jms1005/coss-led-pedd-analyzer/계획서_수정사항.md

# 계획서 수정 항목 — 적용 완료 (2026-09-03)

> ✅ **①②③④는 `LED_PEDD_계획서_최종본.docx`에 이미 반영했습니다.**
> 원본은 `backup/LED_PEDD_계획서_최종본_원본_20260903.docx`에 보관돼 있습니다.
>
> ⚠️ **⑤ 그림 삽입만 Word에서 직접 하셔야 합니다.** 해당 위치에
> `★ ... 교체할 것 ★` 표시를 넣어두었으니 그 문단을 지우고 그림을 넣으세요.
>
> ⑥은 실험 후에 채우는 항목입니다.

아래는 무엇을 왜 바꿨는지에 대한 기록입니다.

`LED_PEDD_계획서_최종본.docx` 검토 결과, 실제 진행에 앞서 고쳐야 할 곳입니다.
**①②③은 안 고치면 실험이 진행되지 않는 항목**이고, ④⑤⑥은 문서 완성도 항목입니다.

원본 파일은 제출용이라 임의로 수정하지 않았습니다.
아래대로 직접 고치시거나, 말씀해주시면 제가 반영하겠습니다.

---

## ① 5.1절 BOM — 누락 부품 (Uno 보드 사용 결정 반영)

> **2026-09-03 갱신.** Arduino Uno 호환보드를 쓰기로 결정했으므로 크리스털·
> 커패시터·USB-TTL은 **구매할 필요가 없습니다**(보드에 실장되어 있음).
> 다만 아래 크리스털·22pF는 **제출용 원가표에는 남겨야** 합니다. 5.1절은
> "ATmega328P IC 단품 5,000원" 기준의 최종 시스템 원가표인데, 단품 구성에는
> 크리스털이 실제로 필요하기 때문입니다. USB-TTL은 최종 시스템의 출력이
> OLED이므로(1.4절) 원가표에서도 제외합니다.
>
> 실제 구매 목록은 `구매목록.md`를 보세요.

### 16MHz 크리스털 + 22pF 커패시터

계획서 3.6절은 **"16 MHz 동작 기준"** 으로 프리스케일러 /8에서 500ns
분해능을 도출하고, 이것이 프리스케일러 선정의 유일한 근거로 쓰였습니다.

그런데 ATmega328P **DIP 단품은 공장 출하 시 내부 8MHz RC 발진기**로
동작합니다. 외부 크리스털과 로드 커패시터가 없으면 16MHz가 나오지
않고, 분해능은 계획서가 말한 500ns가 아니라 1μs가 됩니다.
게다가 내부 RC는 온도에 따라 수 % 흔들려서, 온도 안정성을 확보하려고
밴드갭 기준을 고른 3.2절의 논리와도 어긋납니다.

BOM 표에 다음 행을 추가하세요.

| 품목 | 사양 | 수량 | 예상 단가 | 소계 | 비고 |
|---|---|---|---|---|---|
| 크리스털 | 16 MHz HC-49S | 1 | 300 | 300 | 클럭 정확도 확보 |
| 세라믹 커패시터 | 22 pF | 2 | 50 | 100 | 크리스털 로드 |

> Arduino Uno 보드에는 이미 실장되어 있습니다. 하지만 경제성 산출은
> IC 단품 기준으로 하므로, BOM에는 반드시 들어가야 합니다.

### USB-TTL 시리얼 어댑터

계획서 6.4절 5항은 "모든 원시 측정값을 UART로 PC에 로깅"한다고 했고,
3.5절 핀 표에도 UART 2핀이 잡혀 있습니다. 그런데 **ATmega328P의 UART는
TTL 레벨 신호일 뿐, PC의 USB에 직접 연결되지 않습니다.**
변환 어댑터가 없으면 데이터를 받을 방법이 없습니다.

**결론: 구매도 원가표 계상도 불필요합니다.** Uno 보드의 USB 단자가 이
역할을 하고, 최종 시스템의 출력은 OLED이므로 완성품에는 들어가지 않습니다.

### 합계 갱신

크리스털 300 + 22pF 100 = 400원 추가.
④항의 누락 부품까지 합한 최종 합계는 아래 ④의 표를 보세요.

---

## ② 5.3절 구매 전략 — 전제가 성립하지 않음 (필수)

**현재 문장**

> 정식 부품 발주 전, Phase 1 개념 증명은 보유 중인 LED와 개발 보드만으로
> 우선 수행한다. 개념 증명이 성공적으로 확인된 이후에 RGB 확장용 LED와
> 표시 장치를 구매하여 불필요한 지출과 시간 낭비를 방지한다.

**문제점**

이 전략은 LED와 개발 보드를 이미 갖고 있다는 전제 위에 서 있는데,
실제로는 아무것도 보유하고 있지 않습니다. 그대로 따르면 Phase 1을
위해 한 번 주문하고 배송을 기다린 뒤, Phase 2를 위해 다시 주문하고 또
기다리게 됩니다. **예선 마감까지 15일뿐이라 배송 대기를 두 번 감당할
여유가 없습니다.**

**수정안**

> 부품을 보유하고 있지 않으므로, 착수 시점에 Phase 1~2에 필요한 부품을
> 일괄 발주한다. 개발 기간이 제한되어 있어 단계별 분할 발주 시 배송
> 대기가 반복되고, 이는 실험 일정에 직접적인 지연 요인이 되기 때문이다.
> 다만 최종 시연용 표시 장치(OLED)와 소모품은 Phase 1~2 결과에 따라
> 구성이 바뀔 수 있으므로 예비 수량만 확보한다. 파장별 LED는 개체차
> 보정 실험(4.3절)에 필요하므로 파장당 5개 이상 확보한다. 개발 보드는
> 파손 시 일정 지연이 크므로 예비 1대를 함께 확보한다.

**추가로 삭제할 문장**

5.3절 마지막의 다음 문장을 지우세요.

> ~~다만 ISP 프로그래머는 툴체인 검증에 필요하므로 착수 시점에 함께 확보한다.~~

이 문장은 ATmega328P 단품을 전제한 서술입니다. Arduino Uno 보드는
부트로더를 통해 USB 케이블만으로 업로드되므로 ISP 프로그래머가 필요
없습니다. 대신 예비 보드 1대를 확보하는 쪽이 같은 위험을 더 넓게
막아줍니다(`구매목록.md` 참조).

---

## ③ 5.1절 검출 LED — 발광색이 지정되어 있지 않음 (필수)

현재 사양란은 "투명(무착색)"뿐입니다. 이는 렌즈가 투명하다는 뜻일 뿐
발광색을 지정한 것이 아닙니다. **검출 LED 1개로 R·G·B 3채널을 모두 받는
설계이므로, 검출 LED는 반드시 적색이어야 합니다.**

LED는 자기 밴드갭 이상의 에너지를 가진 광자만 흡수하므로, 반응 가능한
파장이 자기 발광 파장 이하로 제한됩니다(계획서 3.3절이 이미 서술한 내용).
청색·녹색 검출 LED를 쓰면 Red 채널에서 광전류가 거의 흐르지 않아 전부
`TIMEOUT`으로 기록됩니다.

사양란을 **"적색, 투명 렌즈 (약 630nm)"** 로 고치고, 3.3절 검출 소자 선택
근거에도 "검출 LED는 발광부 최장 파장 이상의 소자를 선택한다"는 한 줄을
추가하면 설계 근거가 분명해집니다.

상세는 `구매목록.md` 참조.

---

## ④ 5.1절 BOM — 회로도 작성 중 드러난 누락 부품 4건

회로도(`figures/fig3_schematic.svg`)를 그리면서, 최소 동작 회로에 반드시
필요한데 원가표에 없는 부품이 확인되었습니다. Uno 보드에는 모두 실장되어
있으므로 **구매는 불필요**하지만, IC 단품 기준 원가표에는 계상해야 합니다.

| 품목 | 사양 | 수량 | 예상 단가 | 소계 | 역할 |
|---|---|---|---|---|---|
| 세라믹 커패시터 | 100nF | 2 | 50 | 100 | VCC·AVCC 디커플링 (C1, C2) |
| 세라믹 커패시터 | 10µF | 1 | 100 | 100 | 벌크 커패시터 (C3) |
| 저항 | 10kΩ | 1 | 50 | 50 | RESET 풀업 (R4) |

디커플링 커패시터가 없으면 LED 스위칭 때 발생하는 전원 노이즈가 밴드갭
기준 전압을 흔들어 방전 시간 측정에 직접 오차로 들어옵니다. 빼먹으면
"측정값이 매번 크게 변동"하는 계획서 4.5절의 증상이 나타날 수 있습니다.

RESET 풀업이 없으면 리셋 핀이 뜬 상태가 되어 노이즈에 의한 오동작이
발생합니다.

### 원가표 합계 (적용 결과)

| 구분 | 금액 |
|---|---|
| 계획서 원안 | 25,650원 |
| **ISP 프로그래머 행 삭제** | **−5,000원** |
| ① 크리스털 + 22pF×2 | +400원 |
| ④ 디커플링 3건 + 풀업 1건 | +250원 |
| **적용 후** | **약 21,300원** |

**ISP 프로그래머를 원가표에서 뺀 이유:** BOM은 5.1절 스스로 밝힌 대로
"최종 시스템 1대를 구성하는 데 필요한 부품 목록"입니다. 프로그래머는
시스템의 구성 부품이 아니라 **개발 도구**이고, 계획서는 이미 같은 논리로
멀티미터와 오실로스코프를 목록에서 제외하고 있었습니다. 게다가 우노
부트로더를 쓰기로 해서 실제로 구매하지도 않습니다.

원가가 5,000원 내려가므로 경제성 평가(요강 3-라)에도 유리합니다.
5.1절 하단의 최소 구성 부품비도 5,950원 → **6,600원**으로 갱신했습니다
(클럭·디커플링·리셋 풀업 반영).

> 예상 구매액(약 43,000원 + 큐벳·주사기·시료 별도, `구매목록.md`)과 다른
> 것이 정상입니다. 원가표는 **완성품 1대**의 부품비이고, 구매액에는 예비
> 부품과 실험 지그가 포함되기 때문입니다.
> PPT에서 두 숫자를 혼동하지 않도록 구분해 적으세요.

---

## ⑤ 그림 3건 삽입

| 위치 | 현재 상태 | 사용할 파일 |
|---|---|---|
| 3.1절 `[그림 1] 시스템 블록도 — 삽입 예정` | 비어 있음 | `figures/fig1_block_diagram.svg` |
| 6.8절 `[그림 2] 프로그램 흐름도 — 삽입 예정` | 비어 있음 | `figures/fig2_program_flow.svg` |
| 6.1절 회로 구성 (그림 없음) | 글로만 서술됨 | `figures/fig3_schematic.svg` |

6.1절은 검출 LED 결선을 글로만 설명하고 있습니다. 극성이 이 설계의 핵심
실패 지점이므로, 회로도를 이 절에도 넣으면 전달력이 크게 올라갑니다.

"— 삽입 예정. 위 흐름을 블록 다이어그램으로 작성하여 본 위치에 삽입한다"
같은 **지시문도 함께 지우세요.** 제출본에 남아 있으면 미완성으로 보입니다.

삽입 방법은 `figures/README.md`를 참고하세요.

---

## ⑥ 실험 후 갱신할 곳

실험을 마친 뒤 채워야 하는 자리입니다. 지금은 비워두고 진행하세요.

| 절 | 항목 | 현재 | 확정 시점 |
|---|---|---|---|
| 3.6.2 | Timeout 임계값 | "예비 목표 1~2초" | Phase 1 암전류 분포 측정 후 |
| 3.8.1 | 최종 보정식 | 후보 3종 미결정 | Phase 3 재현성 비교 후 |
| 5.1 | 부품 단가 | 예상치 | 실제 구매 영수증 |
| 5.2 | 절감률 | 산출식만 있음 | 실제 구매가 확정 후 |
| 6.2 | 캡처 에지 방향 | "오실로스코프로 확정" | Phase 1 파형 관찰 후 |

> 펌웨어에는 현재 Timeout 값이 **61회 오버플로우(약 2.0초)** 로 설정되어
> 있습니다. 계획서 예비 목표의 상한을 채택한 값이며, `pedd.c`의
> `TIMEOUT_OVF` 상수 하나만 고치면 됩니다.

---

## 참고 — 수정이 필요 없다고 판단한 부분

검토 과정에서 확인했으나 문제가 없었던 항목입니다.

- **3.5절 핀 배정**: 발광 Red를 PB0에 배정한 것은 문제없습니다. PB0는
  Timer1의 입력 캡처 핀(ICP1)이기도 하지만, 6.2절대로 `ACIC=1`로 두면
  캡처 소스가 Analog Comparator로 바뀌면서 ICP1 핀이 캡처 회로에서
  분리되므로 충돌하지 않습니다. (`pedd.c`에 주석으로 명시해두었습니다)
- **6.2절 캡처 에지**: `ICES1=1`(상승 에지)이 맞습니다. 충전 직후
  V(PD7) > 1.1V 이므로 ACO=0이고, 방전으로 1.1V 아래로 내려가면 ACO가
  0→1로 전이합니다. 데이터시트 기준으로 계획서 서술이 정확합니다.
- **3.8.2절 제곱근 생략**: 유클리드 거리의 대소 관계는 제곱값의 대소
  관계와 같으므로 분류 결과가 달라지지 않습니다. 타당합니다.
