jms1005/coss-led-pedd-analyzer/제출물/예선_PPT_골격.md

# 예선 보고서(PPT) 슬라이드 골격

운영설명 PDF 「4. 예선 제출물 - 가」의 7개 필수 항목을 슬라이드에
**1:1로 대응**시킨 구성입니다. 심사위원이 항목을 찾지 못하면 점수를 줄 수
없으므로, 각 슬라이드 제목에 해당 항목을 그대로 드러냅니다.

권장 분량 18~22장. 괄호 안은 대응하는 요강 항목입니다.

---

## 표지 (1장)

- 작품명: **LED 다파장 재이용 광검출 기반 저비용 액체 광학 분석기**
- 팀명 / 팀원 4인 / 소속
- 한 줄 요약: "포토다이오드 없이, LED만으로 액체를 판별한다"

## 1. 개요 (2장)

**슬라이드 2 — 문제 제기**
- 액체 광학 분석의 기존 구성: 포토다이오드 + TIA + ADC
- 부품 수·비용·아날로그 설계 난이도 문제
- 계획서 1.1절 활용

**슬라이드 3 — 한 장 요약**
- 최종 데모 시나리오 7단계 (계획서 1.4절)
- 완성 사진 또는 동영상 썸네일
- ※ 심사위원이 가장 먼저 보는 장. 여기서 "무엇을 만들었는가"가 즉시
  전달되어야 합니다.

## 2. 시스템의 기능·동작 원리·구조 〔4-가-1〕 (3장)

**슬라이드 4 — PEDD 원리**
- LED 역방향 바이어스 → 광전류 → 정전용량 방전
- 방전 시간 ∝ 1/광량, 전압이 선형에 가깝게 감소하는 이유
- 계획서 3.2절

**슬라이드 5 — 시스템 블록도**
- **`figures/fig1_block_diagram.svg` 삽입**
- 강조점: 신호 처리부(Comparator + Timer1)가 MCU **내부**에 있다

**슬라이드 6 — 다파장 광학 지문**
- RGB 3채널 → 벡터 [R, G, B] → 시료군 분류
- 선행 연구는 1~2 파장 / 단일 분석물에 그침 (계획서 2.2절)

## 3. 시스템 구현 전략 〔4-가-2〕 (4장)

**슬라이드 7 — 프로그램 흐름**
- **`figures/fig2_program_flow.svg` 삽입**

**슬라이드 8 — MCU 선정 근거**
- 계획서 3.4절 표를 그대로 사용
- 핵심 논리: **Analog Comparator + Timer1 Input Capture 조합이
  이 측정 방식에 직접 대응하는 하드웨어**이기 때문에 선택했다
- STM32를 쓰지 않은 이유도 명시 (ADC를 안 쓰므로 이점이 없음)

**슬라이드 9 — 부품 선정**
- 발광 LED를 개별 소자로 쓴 이유 (RGB 일체형은 공통 단자 제약)
- 검출 LED를 **"투명 렌즈 + 적색"** 으로 지정한 이유
  — "투명(무착색)"만으로는 부족하다. 렌즈가 투명하다는 뜻일 뿐 발광색을
  지정한 것이 아니다. 검출 LED 1개로 R·G·B를 모두 받아야 하므로 **적색이
  아니면 Red 채널이 TIMEOUT** 이 된다 (`계획서_수정사항.md` ③항)
- 전류 제한 저항을 4종(220/330/470/1k) 확보한 이유

**슬라이드 10 — 실험 계획**
- Phase 1 → 4 구성과 각 단계 성공 기준 (계획서 4장)
- **예선 시점의 진행 상황을 있는 그대로 적는다.** 현재는 Phase 1~4 펌웨어가
  전부 구현·빌드 검증까지 끝났고, **하드웨어 측정은 아직**이다.
  "Phase 1~2 완료"라고 쓰면 실측 데이터를 요구받았을 때 답할 것이 없다.
  요강 1-나가 "동작하는 결과 못지않게 문제 해결 과정"을 본다고 명시했으므로,
  과장보다 정직한 기재가 유리하다 (`tools/make_ppt.py` 도 "★ 진행 예정"으로
  적고 있다)

## 4. 설계 및 실험 과정 〔4-가-3〕 (4장)

**슬라이드 11 — Phase 1 결과**
- 시료별 방전 시간 분포 그래프, CV 수치
- `tools/analyze.py` 출력 화면 캡처

**슬라이드 12 — Phase 2 결과**
- RGB 3채널 측정값, 채널 추가에 따른 분리도 개선
- 3D 산점도 또는 채널별 막대 그래프

**슬라이드 13 — 시행착오**
- 실제로 겪은 문제와 해결 과정
- 계획서 4.5절 실패 대응표에서 **실제 발생한 것만** 골라 서술
- ※ 요강 1-나: "동작하는 결과 못지않게 중요한 것이 문제 해결 과정"

**슬라이드 14 — 예외 처리**
- Overflow Counter로 32.8ms 한계를 넘긴 방법
- 광 경로 차단 시 Timeout 동작 시연
- ※ 요강 3-마 "예외적 경우에 대한 대비" 대응

## 5. 단위별 상세 설명 〔4-가-4〕 (4장)

**슬라이드 15 — 회로도**
- KiCad 회로도. 검출 LED 극성(캐소드→PD7)을 확대해 강조

**슬라이드 16 — 레지스터 직접 제어**
- 계획서 3.7절 표 + `pedd.c` 핵심 코드 발췌
- ※ 요강 1-라가 가장 높은 배점을 시사한 항목. **여기에 지면을 아끼지 말 것**
- Arduino 라이브러리를 전혀 쓰지 않았음을 명시

**슬라이드 17 — 하드웨어 캡처의 이점**
- 소프트웨어 폴링 대비 ISR 지연이 개입하지 않는 구조
- 선행 연구[4]가 보고한 펌웨어 타이밍 의존성 문제에 대한 대응
- ※ 요강 3-다 "하드웨어와 소프트웨어의 배분" 대응

**슬라이드 18 — 온칩 분류**
- 최근접 중심점, 제곱근 생략, EEPROM 36바이트
- 고정소수점 구현

## 6. 해결하지 못한 부분 〔4-가-5〕 (1장)

**슬라이드 19**
- Phase 3(보정 파이프라인) / Phase 4(온칩 분류)의 진행 상황을 정직하게
- 계획서 8장 한계점 중 실제로 확인된 것
- ※ **이 슬라이드를 비우지 마세요.** 요강이 명시적으로 요구하는 항목이며,
  계획서 7장도 "미완료 부분을 명시하는 것이 누락하는 것보다 유리하다"고
  적어두었습니다.

## 7. 메모리 사용량 〔4-가-6〕 (1장)

**슬라이드 20**
- Microchip Studio 빌드 출력 화면 **캡처 이미지**
- Flash 사용량 / 32KB, SRAM 사용량 / 2KB, EEPROM 사용량
- ※ 수치만 적지 말고 캡처 화면을 넣으라고 명시되어 있습니다

## 8. 부품 가격표 〔4-가-7〕 (1장)

**슬라이드 21**
- 계획서 5.1절 BOM을 **실제 구매가**로 갱신한 표
- 계획서 5.2절 포토다이오드 방식 대비 비교표
- 절감률 = (기존 − 제안) / 기존 × 100
- 사용 핀 수 (최소 4핀 / 최대 13핀) 명시
- ※ 요강 3-라 경제성: 부품 품목·가격·코드 메모리·데이터 메모리 크기가
  모두 평가 대상입니다

---

## 제출 전 최종 확인

- [ ] PPT 파일
- [ ] 회로도 **PDF** (PPT 안의 이미지와 별개로 독립 파일 제출)
- [ ] Source Code (`firmware/` 전체)
- [ ] 동작 동영상
- [ ] 팀원 4명 전원 구글폼 제출 완료
- [ ] 메일 발송: `polaris@disu.ac.kr` (마감 2026-09-18 금)

## 제작 방식 결정 (2026-09-03)

**1단계 — 현재:** `python tools/make_ppt.py` 가 생성하는 pptx 로 내용을 확정한다.
PowerPoint 에서 직접 수정 가능하므로 문구를 다듬기 쉽다.

**2단계 — 실험 종료 후:** HTML/CSS 로 슬라이드를 디자인하고 Chrome 헤드리스로
이미지 렌더한 뒤 pptx 에 삽입하는 방식으로 전환한다(방법 A).
제출 형식이 요강대로 .pptx 로 유지되면서 디자인 자유도를 얻는다.
대신 PowerPoint 에서 글자 수정이 안 되므로, **내용이 확정된 뒤에** 해야 한다.

> 요강 3항 평가 항목 6개 중 디자인과 관련된 것은 "바. 전달력" 하나다.
> 나머지 5개는 실험 데이터와 동작 결과에서 갈리므로 순서를 이렇게 잡았다.

---

## 작성 시 유의점

- **동영상은 편집 없이 한 번에 찍은 컷을 하나는 포함하세요.** 측정부터
  판정 출력까지 끊김 없이 이어지는 장면이 완성도 근거가 됩니다.
- 코드 스크린샷은 폰트를 키우고 핵심 몇 줄만 넣으세요. 전체 코드는
  별도 제출물로 나가므로 슬라이드에 다 넣을 필요가 없습니다.
- 그래프에는 반드시 축 이름과 단위(μs)를 넣으세요. 전달력 항목입니다.
