jms1005/coss-led-pedd-analyzer/docs/superpowers/plans/2026-09-03-phase4.md

# Phase 4 Implementation Plan

> **For agentic workers:** REQUIRED SUB-SKILL: Use superpowers:subagent-driven-development (recommended) or superpowers:executing-plans to implement this plan task-by-task. Steps use checkbox (`- [ ]`) syntax for tracking.

**Goal:** PC 없이 버튼 하나로 시료를 측정·분류해 OLED에 결과를 띄우는 최종 시스템(Phase 4)을 완성한다.

**Architecture:** 기존 `pedd`(방전 시간 측정)·`uart` 위에 6개 모듈을 새로 얹는다. `classify`는 하드웨어 의존이 없는 순수 정수 계산 모듈로 분리해 PC에서 단위 테스트하고, 나머지(`i2c`/`ssd1306`/`button`/`store`)는 레지스터 직접 제어 드라이버다. `04_phase4/main.c`가 상태머신으로 이들을 엮는다.

**Tech Stack:** ATmega328P 16MHz / avr-gcc 5.4.0 (Microchip Studio 7.0.2594) / 호스트 테스트는 MinGW gcc / 빌드 검증은 `atmelstudio.exe /build`

**Spec:** `docs/superpowers/specs/2026-09-03-phase4-design.md`

## Global Constraints

- **Arduino IDE·외부 라이브러리 사용 금지.** 레지스터 직접 read/write. `<avr/io.h>`, `<util/delay.h>`, `<util/atomic.h>`, `<avr/pgmspace.h>`는 컴파일러 제공 헤더이므로 허용.
- **EEPROM은 `eeprom_*` 함수 대신 EECR/EEDR/EEARH/EEARL 직접 제어.**
- **기존 `firmware/common/pedd.c`, `pedd.h`, `uart.c`, `uart.h` 수정 금지.** phase1·phase2가 계속 빌드되어야 한다.
- **주석은 한국어.** 변수·함수명은 영어.
- **들여쓰기 2칸.**
- MCU: `ATmega328P` / `F_CPU=16000000UL` / 최적화 `-Os`
- 폰트 범위 `0x20`~`0x5F` 64자 — **화면 문구는 전부 대문자.**
- 상수: `CLASSIFY_K = 1000000000UL`, `CLASSIFY_MIN_SIGNAL = 3000UL`, `CLASSIFY_SHIFT_LIMIT = 4000000UL`, `CLASSIFY_NORM_SUM = 1000`, `THRESHOLD_D2 = 1600`, `MEASURE_REPEAT = 3`, `LEARN_REPEAT = 8`, OLED 주소 `0x3C`
- 클래스 3종: 인덱스 0 `DISTILLED WATER` / 1 `DYE WATER` / 2 `MILK`, 미상은 `cls = -1`

## File Structure

| 파일 | 책임 | 호스트 컴파일 |
|---|---|:---:|
| `firmware/common/classify.h/.c` | 틱 → 지문 → 판정. 순수 정수 계산 | ✅ |
| `firmware/common/store.h/.c` | EEPROM 중심점 저장/복원 | ❌ |
| `firmware/common/i2c.h/.c` | TWI 마스터 | ❌ |
| `firmware/common/font6x8.h` | 6×8 폰트 테이블 (PROGMEM) | ❌ |
| `firmware/common/ssd1306.h/.c` | OLED 초기화·텍스트 출력 | ❌ |
| `firmware/common/button.h/.c` | 디바운스·짧게/길게 | ❌ |
| `firmware/04_phase4/main.c` | 상태머신·화면 구성·UART 로깅 | ❌ |
| `tests/test_classify.c` | classify 단위 테스트 (호스트) | ✅ |
| `tools/run_host_tests.sh` | 호스트 테스트 빌드·실행 | — |
| `tools/gen_font.py` | 폰트 테이블 생성 | — |

**`classify`만 `<avr/io.h>`를 포함하지 않는다.** 이것이 PC 테스트를 가능하게 하는 유일한 조건이므로 절대 깨뜨리지 말 것.

---

### Task 0: 개발 환경과 프로젝트 껍데기

**Files:**
- Create: `firmware/04_phase4/main.c` (임시 스텁)
- Create: `firmware/04_phase4/phase4.cproj`
- Create: `firmware/04_phase4/phase4.componentinfo.xml`
- Modify: `firmware/PEDD.atsln`
- Create: `tools/run_host_tests.sh`

**Interfaces:**
- Consumes: 없음
- Produces: 빌드 가능한 `phase4` 프로젝트, 호스트 테스트 러너

- [ ] **Step 1: git 저장소 초기화 (선택이지만 권장)**

현재 이 폴더는 git 저장소가 아니다. 작업 단위마다 되돌릴 수 있도록 초기화한다.

```bash
cd "C:/Users/hwali/OneDrive/Desktop/COSS 반도체 경진대회"
git init
printf '%s\n' '*/Debug/' '*/Release/' '.vs/' '*.exe' '*.o' '*.elf' > .gitignore
git add -A && git commit -m "chore: 기존 작업 스냅샷"
git checkout -b feature/phase4
```

건너뛰려면 이후 모든 커밋 단계를 "빌드 검증"으로 대체한다.

- [ ] **Step 2: 호스트 컴파일러 확인**

Run: `gcc --version`
Expected: `gcc (MinGW-W64 x86_64-ucrt-posix-seh ...) 16.1.0`

**설치는 이미 되어 있다.** 다만 winget이 등록한 PATH는 새 셸부터 적용되므로
`command not found`가 나올 수 있다. 그때는 절대 경로를 쓴다:

```
/c/Users/hwali/AppData/Local/Microsoft/WinGet/Packages/BrechtSanders.WinLibs.POSIX.UCRT_Microsoft.Winget.Source_8wekyb3d8bbwe/mingw64/bin/gcc.exe
```

`tools/run_host_tests.sh`는 이 경로를 자동으로 찾도록 작성한다(Step 3).

- [ ] **Step 3: 호스트 테스트 러너 작성**

`tools/run_host_tests.sh`:

```bash
#!/bin/sh
# classify 모듈을 PC에서 컴파일해 실행한다. AVR 하드웨어가 필요 없다.
set -e
ROOT=$(cd "$(dirname "$0")/.." && pwd)
OUT="$ROOT/tools/test_classify.exe"

# winget 이 등록한 PATH 는 새 셸부터 적용된다. 없으면 절대 경로로 넘어간다.
GCC=gcc
if ! command -v gcc >/dev/null 2>&1; then
  GCC="/c/Users/hwali/AppData/Local/Microsoft/WinGet/Packages/BrechtSanders.WinLibs.POSIX.UCRT_Microsoft.Winget.Source_8wekyb3d8bbwe/mingw64/bin/gcc.exe"
fi

"$GCC" -std=c99 -Wall -Wextra -O1 \
    -I"$ROOT/firmware/common" \
    -o "$OUT" \
    "$ROOT/tests/test_classify.c" \
    "$ROOT/firmware/common/classify.c"
"$OUT"
```

- [ ] **Step 4: phase4 스텁 main.c 작성**

`firmware/04_phase4/main.c`:

```c
/*
 * 04_phase4 — 최종 시스템 (스텁)
 *
 * Task 6에서 상태머신으로 대체된다. 지금은 프로젝트 빌드만 확인한다.
 */

#include <avr/io.h>

int main(void) {
  for (;;) {
  }
}
```

- [ ] **Step 5: Studio 프로젝트 파일 생성**

`02_phase1/phase1.cproj`를 복사해 이름만 바꾸는 것이 가장 안전하다.
**`componentinfo.xml`이 없으면 Studio가 프로젝트를 열지 못한다**
(`Value cannot be null. Parameter name: url`).

```bash
cd "C:/Users/hwali/OneDrive/Desktop/COSS 반도체 경진대회/firmware"
cp 02_phase1/phase1.componentinfo.xml 04_phase4/phase4.componentinfo.xml
python - <<'PY'
import io
s = io.open('02_phase1/phase1.cproj', encoding='utf-8-sig').read()
for tag in ('AssemblyName','Name','RootNamespace'):
    s = s.replace('<%s>phase1</%s>' % (tag, tag), '<%s>phase4</%s>' % (tag, tag))
s = s.replace('<ProjectGuid>18ab69c5-eea0-4a6f-9f76-c97db05e0e7e</ProjectGuid>',
              '<ProjectGuid>a4f1c2d8-6b39-4e57-9a02-3c8d1e7b5f40</ProjectGuid>')
io.open('04_phase4/phase4.cproj','w',encoding='utf-8-sig',newline='').write(s)
print('phase4.cproj 생성')
PY
```

솔루션에 등록한다 — `PEDD.atsln`의 `phase2` 항목 바로 뒤에 추가:

```
Project("{54F91283-7BC4-4236-8FF9-10F437C3AD48}") = "phase4", "04_phase4\phase4.cproj", "{A4F1C2D8-6B39-4E57-9A02-3C8D1E7B5F40}"
EndProject
```

그리고 `GlobalSection(ProjectConfigurationPlatforms)` 안에 4줄 추가:

```
		{A4F1C2D8-6B39-4E57-9A02-3C8D1E7B5F40}.Debug|AVR.ActiveCfg = Debug|AVR
		{A4F1C2D8-6B39-4E57-9A02-3C8D1E7B5F40}.Debug|AVR.Build.0 = Debug|AVR
		{A4F1C2D8-6B39-4E57-9A02-3C8D1E7B5F40}.Release|AVR.ActiveCfg = Release|AVR
		{A4F1C2D8-6B39-4E57-9A02-3C8D1E7B5F40}.Release|AVR.Build.0 = Release|AVR
```

들여쓰기는 **탭 2개**다. 공백이면 Studio가 파일을 못 읽는다.

- [ ] **Step 6: 빌드 검증**

Run:
```bash
cd "C:/Users/hwali/OneDrive/Desktop/COSS 반도체 경진대회/firmware"
"/c/Program Files (x86)/Atmel/Studio/7.0/atmelstudio.exe" PEDD.atsln //build Debug //out /tmp/b.log
grep -E "Build:" /tmp/b.log
```
Expected: `========== Build: 4 succeeded or up-to-date, 0 failed, 0 skipped ==========`

`Value cannot be null` 이 나오면 `componentinfo.xml` 누락이거나 솔루션
들여쓰기가 공백이다.

- [ ] **Step 7: 커밋**

```bash
git add firmware/04_phase4 firmware/PEDD.atsln tools/run_host_tests.sh
git commit -m "chore: phase4 프로젝트 껍데기와 호스트 테스트 러너 추가"
```

---

### Task 1: classify 모듈 (지문 계산과 판정)

가장 중요한 태스크다. 32비트 오버플로우가 걸려 있고, 실물에서는 버그가
"가끔 판정이 이상하다"로만 드러나 추적이 어렵다. **TDD로 진행한다.**

**Files:**
- Create: `firmware/common/classify.h`
- Create: `firmware/common/classify.c`
- Test: `tests/test_classify.c`

**Interfaces:**
- Consumes: 없음 (순수 계산)
- Produces:
  - `fingerprint_t classify_fingerprint(uint32_t t_dark, uint32_t t_r, uint32_t t_g, uint32_t t_b)`
  - `classify_result_t classify_match(const fingerprint_t *fp, const uint16_t centroids[3][3], uint32_t threshold_d2)`
  - `uint16_t classify_isqrt(uint32_t v)`
  - 타입 `fingerprint_t{ uint16_t n[3]; classify_status_t status; }`
  - 타입 `classify_result_t{ int8_t cls; uint32_t d2; uint16_t dist; }`

- [ ] **Step 1: 헤더 작성**

`firmware/common/classify.h`:

```c
/*
 * classify.h — 방전 시간을 광학 지문으로 바꾸고 최근접 중심점으로 판정한다.
 *
 * 이 모듈은 의도적으로 <avr/io.h> 를 포함하지 않는다. PC에서 그대로
 * 컴파일해 단위 테스트할 수 있어야 하기 때문이다. 이 조건을 깨뜨리지 말 것.
 */

#ifndef CLASSIFY_H
#define CLASSIFY_H

#include <stdint.h>

#define CLASSIFY_CHANNELS     3
#define CLASSIFY_CLASSES      3

/* 컨덕턴스 스케일 상수. G = K / t 로 정수 유지 */
#define CLASSIFY_K            1000000000UL
/* 정규화 후 세 채널 합의 목표치 */
#define CLASSIFY_NORM_SUM     1000UL
/* 이 값보다 신호 합이 작으면 "빛이 사실상 없음"으로 본다 */
#define CLASSIFY_MIN_SIGNAL   3000UL
/* 곱셈 전 우측 시프트 기준. sum이 이 값 이하여야 i*1000 이 32비트에 들어간다 */
#define CLASSIFY_SHIFT_LIMIT  4000000UL

typedef enum {
  CLASSIFY_OK         = 0,
  CLASSIFY_LOW_SIGNAL = 1
} classify_status_t;

typedef struct {
  uint16_t          n[CLASSIFY_CHANNELS]; /* 정규화 지문. 합 ≈ CLASSIFY_NORM_SUM */
  classify_status_t status;
} fingerprint_t;

typedef struct {
  int8_t   cls;  /* 0~2. 임계값 초과 또는 신호 부족이면 -1 (미상) */
  uint32_t d2;   /* 최소 제곱거리 */
  uint16_t dist; /* 표시용 정수 제곱근 */
} classify_result_t;

/*
 * 방전 시간(틱)을 정규화 지문으로 변환한다.
 * t == 0 은 PEDD_TIMEOUT 을 뜻하며 "빛이 오지 않았다"로 해석한다.
 * DARK 채널의 타임아웃은 정상이며 암전류 보정량이 0이 될 뿐이다.
 */
fingerprint_t classify_fingerprint(uint32_t t_dark, uint32_t t_r,
                                   uint32_t t_g, uint32_t t_b);

/* 지문을 중심점들과 비교해 가장 가까운 클래스를 고른다. */
classify_result_t classify_match(const fingerprint_t *fp,
                                 const uint16_t centroids[CLASSIFY_CLASSES][CLASSIFY_CHANNELS],
                                 uint32_t threshold_d2);

/* 정수 제곱근 (내림). 표시용. */
uint16_t classify_isqrt(uint32_t v);

#endif /* CLASSIFY_H */
```

- [ ] **Step 2: 실패하는 테스트 작성**

`tests/test_classify.c`:

```c
/* classify 모듈 단위 테스트. PC에서 실행한다. */

#include <stdio.h>
#include <stdlib.h>
#include "classify.h"

static int g_fail = 0;

static void check(int cond, const char *name) {
  if (cond) {
    printf("  PASS  %s\n", name);
  } else {
    printf("  FAIL  %s\n", name);
    g_fail++;
  }
}

/* 세 채널이 같으면 지문은 균등해야 한다 */
static void test_uniform(void) {
  fingerprint_t fp = classify_fingerprint(0, 1000, 1000, 1000);
  check(fp.status == CLASSIFY_OK, "균등 입력 - 상태 OK");
  check(fp.n[0] == fp.n[1] && fp.n[1] == fp.n[2], "균등 입력 - 세 채널 동일");
  check(fp.n[0] >= 330 && fp.n[0] <= 334, "균등 입력 - 각 채널 약 333");
}

/* 합은 항상 NORM_SUM 근처여야 한다 (절단 오차 ±3) */
static void test_sum_normalized(void) {
  fingerprint_t fp = classify_fingerprint(0, 1204, 980, 1510);
  uint32_t s = (uint32_t)fp.n[0] + fp.n[1] + fp.n[2];
  check(fp.status == CLASSIFY_OK, "일반 입력 - 상태 OK");
  check(s >= 997 && s <= 1000, "일반 입력 - 합이 1000 근처");
}

/* 밝은 쪽(t가 작은 쪽)이 더 큰 성분을 가져야 한다 */
static void test_ordering(void) {
  fingerprint_t fp = classify_fingerprint(0, 980, 1204, 1510);
  check(fp.n[0] > fp.n[1] && fp.n[1] > fp.n[2], "t가 작을수록 성분이 큼");
}

/* 경계: 최소 t. 오버플로우 없이 정상 정규화되어야 한다 */
static void test_min_t(void) {
  fingerprint_t fp = classify_fingerprint(0, 1, 1, 1);
  uint32_t s = (uint32_t)fp.n[0] + fp.n[1] + fp.n[2];
  check(fp.status == CLASSIFY_OK, "t=1 - 상태 OK");
  check(s >= 997 && s <= 1000, "t=1 - 합이 1000 근처 (오버플로우 없음)");
}

/* 경계: 최대 t (TIMEOUT_OVF 61 x 65536) */
static void test_max_t(void) {
  fingerprint_t fp = classify_fingerprint(0, 3997696UL, 3997696UL, 3997696UL);
  check(fp.status == CLASSIFY_LOW_SIGNAL, "t=최대 - 신호 부족으로 판정");
}

/* 암전류 보정: DARK가 밝으면 각 채널 성분이 줄어야 한다 */
static void test_dark_correction(void) {
  fingerprint_t a = classify_fingerprint(0,      1000, 2000, 4000);
  fingerprint_t b = classify_fingerprint(100000, 1000, 2000, 4000);
  check(a.status == CLASSIFY_OK && b.status == CLASSIFY_OK, "암보정 - 둘 다 OK");
  check(a.n[0] != b.n[0], "암보정 - DARK 값이 지문을 바꿈");
}

/* DARK 타임아웃(0)은 오류가 아니라 보정량 0을 뜻한다 */
static void test_dark_timeout_ok(void) {
  fingerprint_t fp = classify_fingerprint(0, 1204, 980, 1510);
  check(fp.status == CLASSIFY_OK, "DARK=0 - 정상 처리");
}

/* 모든 채널이 타임아웃이면 신호 부족 */
static void test_all_timeout(void) {
  fingerprint_t fp = classify_fingerprint(0, 0, 0, 0);
  check(fp.status == CLASSIFY_LOW_SIGNAL, "전 채널 타임아웃 - 신호 부족");
  check(fp.n[0] == 0 && fp.n[1] == 0 && fp.n[2] == 0, "전 채널 타임아웃 - 지문 0");
}

/* 정확히 일치하는 중심점은 거리 0 */
static void test_match_exact(void) {
  static const uint16_t c[3][3] = { {333,333,333}, {600,200,200}, {200,200,600} };
  fingerprint_t fp = classify_fingerprint(0, 1000, 1000, 1000);
  classify_result_t r = classify_match(&fp, c, 1600);
  check(r.cls == 0, "정확 일치 - 클래스 0");
  check(r.d2 <= 12, "정확 일치 - 거리 거의 0");
}

/* 임계값을 넘으면 미상 */
static void test_match_unknown(void) {
  static const uint16_t c[3][3] = { {900,50,50}, {50,900,50}, {50,50,900} };
  fingerprint_t fp = classify_fingerprint(0, 1000, 1000, 1000);
  classify_result_t r = classify_match(&fp, c, 1600);
  check(r.cls == -1, "임계값 초과 - 미상");
  check(r.d2 > 1600, "임계값 초과 - d2가 임계값보다 큼");
}

/* 신호 부족 지문은 무조건 미상 */
static void test_match_low_signal(void) {
  static const uint16_t c[3][3] = { {333,333,333}, {600,200,200}, {200,200,600} };
  fingerprint_t fp = classify_fingerprint(0, 0, 0, 0);
  classify_result_t r = classify_match(&fp, c, 1600);
  check(r.cls == -1, "신호 부족 - 미상");
}

static void test_isqrt(void) {
  check(classify_isqrt(0) == 0, "isqrt(0)=0");
  check(classify_isqrt(1) == 1, "isqrt(1)=1");
  check(classify_isqrt(1600) == 40, "isqrt(1600)=40");
  check(classify_isqrt(1601) == 40, "isqrt(1601)=40 (내림)");
  check(classify_isqrt(3000000UL) == 1732, "isqrt(3000000)=1732");
}

int main(void) {
  printf("== classify 단위 테스트 ==\n");
  test_uniform();
  test_sum_normalized();
  test_ordering();
  test_min_t();
  test_max_t();
  test_dark_correction();
  test_dark_timeout_ok();
  test_all_timeout();
  test_match_exact();
  test_match_unknown();
  test_match_low_signal();
  test_isqrt();
  printf("== 실패 %d건 ==\n", g_fail);
  return g_fail == 0 ? 0 : 1;
}
```

- [ ] **Step 3: 테스트가 실패하는지 확인**

Run: `sh tools/run_host_tests.sh`
Expected: 컴파일 실패 — `classify.c: No such file or directory`

- [ ] **Step 4: 구현 작성**

`firmware/common/classify.c`:

```c
/*
 * classify.c — 광학 지문 계산과 최근접 중심점 판정
 *
 * 설계 근거는 docs/superpowers/specs/2026-09-03-phase4-design.md 7절.
 * 전 구간 32비트 정수. float 를 쓰지 않으므로 소프트웨어 부동소수점
 * 라이브러리(약 1.5~3KB Flash)가 링크되지 않는다.
 */

#include "classify.h"

/*
 * 방전 시간을 컨덕턴스로 바꾼다. 빛이 셀수록 t가 작고 G가 크다.
 * t == 0 은 타임아웃이며 "빛이 오지 않았다" = G 0 으로 본다.
 * t 최소값 1일 때 G = 1e9 이므로 세 채널 합의 최대는 3e9 < 4.29e9 (uint32 상한).
 */
static uint32_t conductance(uint32_t t) {
  if (t == 0) {
    return 0;
  }
  return CLASSIFY_K / t;
}

fingerprint_t classify_fingerprint(uint32_t t_dark, uint32_t t_r,
                                   uint32_t t_g, uint32_t t_b) {
  fingerprint_t fp;
  uint32_t t_ch[CLASSIFY_CHANNELS];
  uint32_t i[CLASSIFY_CHANNELS];
  uint32_t g_dark;
  uint32_t sum = 0;
  uint8_t k;

  t_ch[0] = t_r;
  t_ch[1] = t_g;
  t_ch[2] = t_b;

  g_dark = conductance(t_dark);

  /* 암전류 보정. 음수는 0으로 클램프한다. */
  for (k = 0; k < CLASSIFY_CHANNELS; k++) {
    uint32_t g = conductance(t_ch[k]);
    i[k] = (g > g_dark) ? (g - g_dark) : 0;
    sum += i[k];
  }

  if (sum < CLASSIFY_MIN_SIGNAL) {
    for (k = 0; k < CLASSIFY_CHANNELS; k++) {
      fp.n[k] = 0;
    }
    fp.status = CLASSIFY_LOW_SIGNAL;
    return fp;
  }

  /*
   * 곱셈이 32비트에 들어갈 때까지 세 채널을 함께 우측 시프트한다.
   * 동일 배율이므로 채널 간 비율(=지문)은 보존된다.
   * 시프트 후 sum <= 4e6, i[k] <= sum 이므로 i[k]*1000 <= 4.0e9 < 4.29e9.
   */
  while (sum > CLASSIFY_SHIFT_LIMIT) {
    sum = 0;
    for (k = 0; k < CLASSIFY_CHANNELS; k++) {
      i[k] >>= 1;
      sum += i[k];
    }
  }

  /* 시프트로 sum이 0이 되는 일은 없지만 0 나누기를 원천 차단한다. */
  if (sum == 0) {
    for (k = 0; k < CLASSIFY_CHANNELS; k++) {
      fp.n[k] = 0;
    }
    fp.status = CLASSIFY_LOW_SIGNAL;
    return fp;
  }

  for (k = 0; k < CLASSIFY_CHANNELS; k++) {
    fp.n[k] = (uint16_t)((i[k] * CLASSIFY_NORM_SUM) / sum);
  }
  fp.status = CLASSIFY_OK;
  return fp;
}

classify_result_t classify_match(const fingerprint_t *fp,
                                 const uint16_t centroids[CLASSIFY_CLASSES][CLASSIFY_CHANNELS],
                                 uint32_t threshold_d2) {
  classify_result_t r;
  uint32_t best = 0xFFFFFFFFUL;
  int8_t   best_c = -1;
  uint8_t  c, k;

  r.cls  = -1;
  r.d2   = 0xFFFFFFFFUL;
  r.dist = 0;

  if (fp->status != CLASSIFY_OK) {
    return r;
  }

  for (c = 0; c < CLASSIFY_CLASSES; c++) {
    uint32_t d2 = 0;
    for (k = 0; k < CLASSIFY_CHANNELS; k++) {
      int32_t diff = (int32_t)fp->n[k] - (int32_t)centroids[c][k];
      d2 += (uint32_t)(diff * diff);
    }
    if (d2 < best) {
      best   = d2;
      best_c = (int8_t)c;
    }
  }

  r.d2   = best;
  r.dist = classify_isqrt(best);
  r.cls  = (best <= threshold_d2) ? best_c : -1;
  return r;
}

uint16_t classify_isqrt(uint32_t v) {
  uint32_t x, y;

  if (v == 0) {
    return 0;
  }
  x = v;
  y = (x + 1) / 2;
  while (y < x) {
    x = y;
    y = (x + v / x) / 2;
  }
  return (uint16_t)x;
}
```

- [ ] **Step 5: 테스트 통과 확인**

Run: `sh tools/run_host_tests.sh`
Expected: 모든 줄이 `PASS`, 마지막 줄 `== 실패 0건 ==`, 종료 코드 0

실패하면 **테스트가 아니라 구현을 고친다.** 테스트의 기대값은 스펙 7절의
계산에서 나온 것이다.

- [ ] **Step 6: AVR 빌드도 되는지 확인**

`04_phase4/phase4.cproj`의 `<ItemGroup>`에 `classify.c`/`classify.h`를 추가한다
(`02_phase1/phase1.cproj`의 `pedd.c` 항목과 같은 형식, `<Link>` 는 파일명만).

Run: `atmelstudio.exe PEDD.atsln //build Debug //out /tmp/b.log` 후 `grep "Build:" /tmp/b.log`
Expected: `Build: 4 succeeded`

- [ ] **Step 7: 커밋**

```bash
git add firmware/common/classify.h firmware/common/classify.c tests/test_classify.c firmware/04_phase4/phase4.cproj
git commit -m "feat: 광학 지문 계산과 최근접 중심점 분류 모듈 추가"
```

---

### Task 2: store 모듈 (EEPROM 중심점 저장)

**Files:**
- Create: `firmware/common/store.h`
- Create: `firmware/common/store.c`
- Modify: `firmware/04_phase4/phase4.cproj`

**Interfaces:**
- Consumes: `classify.h`의 `CLASSIFY_CLASSES`, `CLASSIFY_CHANNELS`
- Produces:
  - `uint8_t store_load(uint16_t centroids[3][3], uint32_t *threshold_d2)` — 유효하면 1
  - `void store_save(const uint16_t centroids[3][3], uint32_t threshold_d2)`
  - `void store_erase(void)`

- [ ] **Step 1: 헤더 작성**

`firmware/common/store.h`:

```c
/*
 * store.h — 학습된 중심점을 EEPROM에 보관한다.
 *
 * avr-libc 의 eeprom_* 함수 대신 EECR/EEDR/EEARH/EEARL 레지스터를 직접
 * 제어한다. 요강의 "레지스터 직접 read/write" 취지에 맞춘다.
 */

#ifndef STORE_H
#define STORE_H

#include <stdint.h>
#include "classify.h"

/* EEPROM 배치 (스펙 8절). 총 26바이트 */
#define STORE_ADDR_MAGIC      0
#define STORE_ADDR_VERSION    2
#define STORE_ADDR_COUNT      3
#define STORE_ADDR_CENTROIDS  4
#define STORE_ADDR_THRESHOLD  22
#define STORE_ADDR_CHECKSUM   24
#define STORE_SIZE            26

#define STORE_MAGIC    0x5044u
#define STORE_VERSION  1

/*
 * 저장된 중심점을 읽는다. 매직·버전·클래스 수·체크섬이 모두 맞아야 1을
 * 반환한다. 공장 출하 EEPROM은 전부 0xFF 라 자연스럽게 무효로 걸러진다.
 * 0을 반환하면 인자는 건드리지 않는다.
 */
uint8_t store_load(uint16_t centroids[CLASSIFY_CLASSES][CLASSIFY_CHANNELS],
                   uint32_t *threshold_d2);

/* 중심점 전체를 한 번에 기록한다. 학습이 끝난 뒤에만 호출한다. */
void store_save(const uint16_t centroids[CLASSIFY_CLASSES][CLASSIFY_CHANNELS],
                uint32_t threshold_d2);

/* 매직을 지워 "학습 안 됨" 상태로 되돌린다. */
void store_erase(void);

#endif /* STORE_H */
```

- [ ] **Step 2: 구현 작성**

`firmware/common/store.c`:

```c
/*
 * store.c — EEPROM 접근 (레지스터 직접 제어)
 */

#include <avr/io.h>
#include <util/atomic.h>

#include "store.h"

static uint8_t ee_read(uint16_t addr) {
  /* 이전 쓰기가 끝날 때까지 대기 */
  while (EECR & (1 << EEPE)) {
  }
  EEARH = (uint8_t)(addr >> 8);
  EEARL = (uint8_t)(addr & 0xFF);
  EECR |= (1 << EERE);
  return EEDR;
}

static void ee_write(uint16_t addr, uint8_t value) {
  while (EECR & (1 << EEPE)) {
  }
  EEARH = (uint8_t)(addr >> 8);
  EEARL = (uint8_t)(addr & 0xFF);
  EEDR  = value;
  /*
   * EEMPE 를 세운 뒤 4클럭 안에 EEPE 를 세워야 한다.
   * 인터럽트가 끼어들면 이 창을 놓치므로 원자 구간으로 감싼다.
   */
  ATOMIC_BLOCK(ATOMIC_RESTORESTATE) {
    EECR |= (1 << EEMPE);
    EECR |= (1 << EEPE);
  }
}

static uint16_t ee_read16(uint16_t addr) {
  return (uint16_t)ee_read(addr) | ((uint16_t)ee_read(addr + 1) << 8);
}

static void ee_write16(uint16_t addr, uint16_t value) {
  ee_write(addr,     (uint8_t)(value & 0xFF));
  ee_write(addr + 1, (uint8_t)(value >> 8));
}

/* 앞 24바이트의 단순 합. 상위 비트는 버린다. */
static uint16_t checksum_stored(void) {
  uint16_t sum = 0;
  uint16_t a;
  for (a = 0; a < STORE_ADDR_CHECKSUM; a++) {
    sum = (uint16_t)(sum + ee_read(a));
  }
  return sum;
}

uint8_t store_load(uint16_t centroids[CLASSIFY_CLASSES][CLASSIFY_CHANNELS],
                   uint32_t *threshold_d2) {
  uint8_t c, k;
  uint16_t addr;

  if (ee_read16(STORE_ADDR_MAGIC) != STORE_MAGIC) {
    return 0;
  }
  if (ee_read(STORE_ADDR_VERSION) != STORE_VERSION) {
    return 0;
  }
  if (ee_read(STORE_ADDR_COUNT) != CLASSIFY_CLASSES) {
    return 0;
  }
  if (ee_read16(STORE_ADDR_CHECKSUM) != checksum_stored()) {
    return 0;
  }

  addr = STORE_ADDR_CENTROIDS;
  for (c = 0; c < CLASSIFY_CLASSES; c++) {
    for (k = 0; k < CLASSIFY_CHANNELS; k++) {
      centroids[c][k] = ee_read16(addr);
      addr += 2;
    }
  }
  *threshold_d2 = ee_read16(STORE_ADDR_THRESHOLD);
  return 1;
}

void store_save(const uint16_t centroids[CLASSIFY_CLASSES][CLASSIFY_CHANNELS],
                uint32_t threshold_d2) {
  uint8_t c, k;
  uint16_t addr;

  ee_write16(STORE_ADDR_MAGIC, STORE_MAGIC);
  ee_write(STORE_ADDR_VERSION, STORE_VERSION);
  ee_write(STORE_ADDR_COUNT,   CLASSIFY_CLASSES);

  addr = STORE_ADDR_CENTROIDS;
  for (c = 0; c < CLASSIFY_CLASSES; c++) {
    for (k = 0; k < CLASSIFY_CHANNELS; k++) {
      ee_write16(addr, centroids[c][k]);
      addr += 2;
    }
  }
  ee_write16(STORE_ADDR_THRESHOLD, (uint16_t)threshold_d2);

  /* 체크섬은 나머지를 모두 기록한 뒤 마지막에 쓴다. */
  ee_write16(STORE_ADDR_CHECKSUM, checksum_stored());
}

void store_erase(void) {
  ee_write16(STORE_ADDR_MAGIC, 0xFFFF);
}
```

- [ ] **Step 3: 프로젝트에 추가하고 빌드 검증**

`phase4.cproj`에 `store.c`/`store.h` 추가 후:

Run: `atmelstudio.exe PEDD.atsln //build Debug //out /tmp/b.log` 후 `grep "Build:" /tmp/b.log`
Expected: `Build: 4 succeeded`

> 이 모듈은 `<avr/io.h>`를 쓰므로 호스트 테스트 대상이 아니다.
> 실제 동작 검증은 Task 7의 하드웨어 브링업에서 한다.

- [ ] **Step 4: 커밋**

```bash
git add firmware/common/store.h firmware/common/store.c firmware/04_phase4/phase4.cproj
git commit -m "feat: EEPROM 중심점 저장 모듈 추가"
```

---

### Task 3: i2c 모듈 (TWI 마스터)

**Files:**
- Create: `firmware/common/i2c.h`
- Create: `firmware/common/i2c.c`
- Modify: `firmware/04_phase4/phase4.cproj`

**Interfaces:**
- Consumes: 없음
- Produces:
  - `void i2c_init(void)`
  - `uint8_t i2c_start(uint8_t addr7, uint8_t read)` — 성공 1
  - `uint8_t i2c_write(uint8_t data)` — 성공 1
  - `void i2c_stop(void)`

- [ ] **Step 1: 헤더 작성**

`firmware/common/i2c.h`:

```c
/*
 * i2c.h — TWI(I2C) 마스터 송신 전용
 *
 * TWBR/TWCR/TWDR/TWSR 레지스터를 직접 제어한다.
 * 모든 함수는 유한 시간 안에 반환한다. 슬레이브가 없어도 멈추지 않아야
 * 측정과 UART 로깅이 계속될 수 있다 (스펙 9절).
 */

#ifndef I2C_H
#define I2C_H

#include <stdint.h>

void    i2c_init(void);
uint8_t i2c_start(uint8_t addr7, uint8_t read);
uint8_t i2c_write(uint8_t data);
void    i2c_stop(void);

#endif /* I2C_H */
```

- [ ] **Step 2: 구현 작성**

`firmware/common/i2c.c`:

```c
/*
 * i2c.c — TWI 마스터
 */

#include <avr/io.h>

#include "i2c.h"

/*
 * SCL = F_CPU / (16 + 2 * TWBR * 4^TWPS)
 * TWPS = 0, TWBR = 12 -> 16000000 / (16 + 24) = 400kHz
 * SSD1306은 400kHz를 지원한다. 화면 갱신 속도에 직접 영향을 준다.
 */
#define I2C_TWBR_400K  12

/* TWINT 대기 상한. 슬레이브가 없을 때 무한 대기를 막는다. */
#define I2C_GUARD  20000u

static uint8_t wait_twint(void) {
  uint16_t guard = 0;
  while (!(TWCR & (1 << TWINT))) {
    if (++guard >= I2C_GUARD) {
      return 0;
    }
  }
  return 1;
}

void i2c_init(void) {
  TWSR = 0;                 /* 프리스케일러 1 */
  TWBR = I2C_TWBR_400K;
  TWCR = (1 << TWEN);
}

uint8_t i2c_start(uint8_t addr7, uint8_t read) {
  uint8_t status;

  TWCR = (1 << TWINT) | (1 << TWSTA) | (1 << TWEN);
  if (!wait_twint()) {
    return 0;
  }
  status = (uint8_t)(TWSR & 0xF8);
  /* 0x08 = START 전송됨, 0x10 = 반복 START 전송됨 */
  if (status != 0x08 && status != 0x10) {
    return 0;
  }

  TWDR = (uint8_t)((addr7 << 1) | (read ? 1 : 0));
  TWCR = (1 << TWINT) | (1 << TWEN);
  if (!wait_twint()) {
    return 0;
  }
  status = (uint8_t)(TWSR & 0xF8);
  /* 0x18 = SLA+W 에 ACK, 0x40 = SLA+R 에 ACK */
  return (status == 0x18 || status == 0x40) ? 1 : 0;
}

uint8_t i2c_write(uint8_t data) {
  TWDR = data;
  TWCR = (1 << TWINT) | (1 << TWEN);
  if (!wait_twint()) {
    return 0;
  }
  /* 0x28 = 데이터 전송 후 ACK */
  return ((TWSR & 0xF8) == 0x28) ? 1 : 0;
}

void i2c_stop(void) {
  uint16_t guard = 0;
  TWCR = (1 << TWINT) | (1 << TWSTO) | (1 << TWEN);
  /* STOP 완료는 TWSTO 가 자동으로 내려가는 것으로 확인한다. */
  while (TWCR & (1 << TWSTO)) {
    if (++guard >= I2C_GUARD) {
      return;
    }
  }
}
```

- [ ] **Step 3: 빌드 검증**

`phase4.cproj`에 추가 후 Run: `atmelstudio.exe PEDD.atsln //build Debug //out /tmp/b.log`
Expected: `Build: 4 succeeded`

- [ ] **Step 4: 커밋**

```bash
git add firmware/common/i2c.h firmware/common/i2c.c firmware/04_phase4/phase4.cproj
git commit -m "feat: TWI 마스터 드라이버 추가"
```

---

### Task 4: 폰트와 SSD1306 드라이버

**Files:**
- Create: `tools/gen_font.py`
- Create: `firmware/common/font6x8.h`
- Create: `firmware/common/ssd1306.h`
- Create: `firmware/common/ssd1306.c`
- Modify: `firmware/04_phase4/phase4.cproj`

**Interfaces:**
- Consumes: `i2c.h`
- Produces:
  - `uint8_t ssd1306_init(void)` — 성공 1, OLED 없으면 0
  - `void ssd1306_clear(void)`
  - `void ssd1306_puts(uint8_t page, uint8_t col, const char *s)`
  - `static const uint8_t FONT6X8[64][6] PROGMEM` (font6x8.h 내부)

- [ ] **Step 1: 폰트 생성 스크립트 작성**

384바이트를 손으로 입력하면 오타가 난다. 5×7 비트맵을 문자열로 적고
스크립트로 변환한다.

`tools/gen_font.py`:

```python
"""ASCII 0x20~0x5F 64자의 6x8 폰트 테이블을 생성한다.

각 글자는 5픽셀 폭 + 1픽셀 간격 = 6바이트. 바이트 하나가 세로 8픽셀이고
최하위 비트가 맨 위 줄이다 (SSD1306 페이지 주소 모드 규약).
"""
import io

# 5x7 글리프. 행 7개, 각 행 5글자. '#'이 켜진 픽셀.
# 여기에 없는 문자(예: $ % & @ [ ] 등)는 공백으로 채워진다. 화면 문구에
# 쓰이지 않기 때문이며, VERIFY 목록이 이를 강제한다.
GLYPHS = {
    ' ': ["     ", "     ", "     ", "     ", "     ", "     ", "     "],
    '!': ["  #  ", "  #  ", "  #  ", "  #  ", "  #  ", "     ", "  #  "],
    '.': ["     ", "     ", "     ", "     ", "     ", "     ", "  #  "],
    '/': ["    #", "    #", "   # ", "  #  ", " #   ", "#    ", "#    "],
    ':': ["     ", "  #  ", "  #  ", "     ", "  #  ", "  #  ", "     "],
    '-': ["     ", "     ", "     ", "#####", "     ", "     ", "     "],
    '0': [" ### ", "#   #", "#  ##", "# # #", "##  #", "#   #", " ### "],
    '1': ["  #  ", " ##  ", "  #  ", "  #  ", "  #  ", "  #  ", " ### "],
    '2': [" ### ", "#   #", "    #", "   # ", "  #  ", " #   ", "#####"],
    '3': ["#####", "   # ", "  ## ", "    #", "    #", "#   #", " ### "],
    '4': ["   # ", "  ## ", " # # ", "#  # ", "#####", "   # ", "   # "],
    '5': ["#####", "#    ", "#### ", "    #", "    #", "#   #", " ### "],
    '6': ["  ## ", " #   ", "#    ", "#### ", "#   #", "#   #", " ### "],
    '7': ["#####", "    #", "   # ", "  #  ", " #   ", " #   ", " #   "],
    '8': [" ### ", "#   #", "#   #", " ### ", "#   #", "#   #", " ### "],
    '9': [" ### ", "#   #", "#   #", " ####", "    #", "   # ", " ##  "],
    'A': [" ### ", "#   #", "#   #", "#####", "#   #", "#   #", "#   #"],
    'B': ["#### ", "#   #", "#   #", "#### ", "#   #", "#   #", "#### "],
    'C': [" ### ", "#   #", "#    ", "#    ", "#    ", "#   #", " ### "],
    'D': ["###  ", "#  # ", "#   #", "#   #", "#   #", "#  # ", "###  "],
    'E': ["#####", "#    ", "#    ", "#### ", "#    ", "#    ", "#####"],
    'F': ["#####", "#    ", "#    ", "#### ", "#    ", "#    ", "#    "],
    'G': [" ### ", "#   #", "#    ", "#  ##", "#   #", "#   #", " ####"],
    'H': ["#   #", "#   #", "#   #", "#####", "#   #", "#   #", "#   #"],
    'I': [" ### ", "  #  ", "  #  ", "  #  ", "  #  ", "  #  ", " ### "],
    'J': ["    #", "    #", "    #", "    #", "#   #", "#   #", " ### "],
    'K': ["#   #", "#  # ", "# #  ", "##   ", "# #  ", "#  # ", "#   #"],
    'L': ["#    ", "#    ", "#    ", "#    ", "#    ", "#    ", "#####"],
    'M': ["#   #", "## ##", "# # #", "# # #", "#   #", "#   #", "#   #"],
    'N': ["#   #", "##  #", "# # #", "#  ##", "#   #", "#   #", "#   #"],
    'O': [" ### ", "#   #", "#   #", "#   #", "#   #", "#   #", " ### "],
    'P': ["#### ", "#   #", "#   #", "#### ", "#    ", "#    ", "#    "],
    'Q': [" ### ", "#   #", "#   #", "#   #", "# # #", "#  # ", " ## #"],
    'R': ["#### ", "#   #", "#   #", "#### ", "# #  ", "#  # ", "#   #"],
    'S': [" ####", "#    ", "#    ", " ### ", "    #", "    #", "#### "],
    'T': ["#####", "  #  ", "  #  ", "  #  ", "  #  ", "  #  ", "  #  "],
    'U': ["#   #", "#   #", "#   #", "#   #", "#   #", "#   #", " ### "],
    'V': ["#   #", "#   #", "#   #", "#   #", "#   #", " # # ", "  #  "],
    'W': ["#   #", "#   #", "#   #", "# # #", "# # #", "## ##", "#   #"],
    'X': ["#   #", "#   #", " # # ", "  #  ", " # # ", "#   #", "#   #"],
    'Y': ["#   #", "#   #", " # # ", "  #  ", "  #  ", "  #  ", "  #  "],
    'Z': ["#####", "    #", "   # ", "  #  ", " #   ", "#    ", "#####"],
}

# 스펙 6절 화면 문구에 실제로 등장하는 모든 문자. 하나라도 글리프가
# 없으면 생성을 중단한다. 빈 글자가 화면에 나가는 사고를 막는다.
VERIFY = (
    "LED PEDD ANALYZER READY SHORT MEASURE LONG LEARN NOT TRAINED "
    "HOLD BTN 2S TO RESULT US DARK DIST THR 1/3 2/3 3/3 "
    "PUT DISTILLED WATER DYE MILK CANCEL SAVED EEPROM CLASSES STORED "
    "ERROR TIMEOUT CHECK POLARITY BACK UNKNOWN LOW SIGNAL OK "
    "0123456789.:-!"
)

ORDER = [chr(c) for c in range(0x20, 0x60)]

def glyph_bytes(rows):
    out = []
    for x in range(5):
        b = 0
        for y in range(7):
            if rows[y][x] == '#':
                b |= (1 << y)
        out.append(b)
    out.append(0)  # 글자 사이 간격
    return out

def verify():
    missing = sorted({c for c in VERIFY if c != ' ' and c not in GLYPHS})
    if missing:
        raise SystemExit('글리프 없음: %s' % ' '.join(missing))
    for ch, rows in GLYPHS.items():
        if len(rows) != 7 or any(len(r) != 5 for r in rows):
            raise SystemExit('글리프 크기 오류: %r' % ch)

def main():
    verify()
    lines = []
    lines.append('/*')
    lines.append(' * font6x8.h - 6x8 폰트 테이블 (tools/gen_font.py 로 생성. 직접 수정하지 말 것)')
    lines.append(' *')
    lines.append(' * ASCII 0x20~0x5F 64자. 소문자는 없다 - 화면 문구는 전부 대문자다.')
    lines.append(' * PROGMEM 에 두어 SRAM 을 쓰지 않는다 (384바이트).')
    lines.append(' */')
    lines.append('')
    lines.append('#ifndef FONT6X8_H')
    lines.append('#define FONT6X8_H')
    lines.append('')
    lines.append('#include <stdint.h>')
    lines.append('#include <avr/pgmspace.h>')
    lines.append('')
    lines.append('#define FONT_FIRST_CHAR 0x20')
    lines.append('#define FONT_LAST_CHAR  0x5F')
    lines.append('#define FONT_WIDTH      6')
    lines.append('')
    lines.append('static const uint8_t FONT6X8[64][6] PROGMEM = {')
    for ch in ORDER:
        rows = GLYPHS.get(ch, GLYPHS[' '])
        bs = glyph_bytes(rows)
        name = 'space' if ch == ' ' else ch
        lines.append('  {%s},  /* %s */' % (
            ', '.join('0x%02X' % b for b in bs), name))
    lines.append('};')
    lines.append('')
    lines.append('#endif /* FONT6X8_H */')
    io.open('firmware/common/font6x8.h', 'w', encoding='utf-8',
            newline='\n').write('\n'.join(lines) + '\n')
    print('font6x8.h 생성: %d자' % len(ORDER))

if __name__ == '__main__':
    main()
```

- [ ] **Step 2: 폰트 헤더 생성 및 검증**

Run: `python tools/gen_font.py`
Expected: `font6x8.h 생성: 64자`, 그리고 `firmware/common/font6x8.h` 가 생김

`글리프 없음:` 으로 중단되면 `GLYPHS` 에 그 문자를 추가한다.
스펙 6절 화면 문구에 쓰이는 문자는 `VERIFY` 가 전부 강제하므로,
빈 글자가 화면에 나가는 사고는 이 단계에서 걸린다.

생성 결과를 눈으로 확인한다:

Run: `grep -c '},' firmware/common/font6x8.h`
Expected: `64`

- [ ] **Step 3: SSD1306 헤더 작성**

`firmware/common/ssd1306.h`:

```c
/*
 * ssd1306.h — 0.96" 128x64 OLED 텍스트 출력
 *
 * 프레임버퍼를 쓰지 않는다. 128x64/8 = 1024바이트로 SRAM 2KB의 절반을
 * 차지하기 때문이다. 대신 페이지 주소 모드로 화면에 직접 쓴다.
 */

#ifndef SSD1306_H
#define SSD1306_H

#include <stdint.h>

#define SSD1306_ADDR     0x3C  /* 모듈에 따라 0x3D 인 제품도 있다 */
#define SSD1306_PAGES    8     /* 세로 8줄 */
#define SSD1306_COLS     128
#define SSD1306_TEXT_COLS 21   /* 128 / 6 */

/* 초기화. OLED가 응답하지 않으면 0을 반환하고, 이후 호출은 조용히 무시된다. */
uint8_t ssd1306_init(void);

void ssd1306_clear(void);

/* page 0~7, col 0~20 (문자 단위). 화면 밖은 잘린다. */
void ssd1306_puts(uint8_t page, uint8_t col, const char *s);

#endif /* SSD1306_H */
```

- [ ] **Step 4: SSD1306 구현 작성**

`firmware/common/ssd1306.c` 전체:

```c
/*
 * ssd1306.c — OLED 드라이버
 */

#include <avr/pgmspace.h>

#include "ssd1306.h"
#include "i2c.h"
#include "font6x8.h"

#define CTRL_CMD   0x00
#define CTRL_DATA  0x40

/* 초기화에 실패하면 이후 모든 출력을 건너뛴다. */
static uint8_t g_ready = 0;

/* 데이터시트 권장 초기화 시퀀스 (128x64) */
static const uint8_t INIT_SEQ[] PROGMEM = {
  0xAE,        /* 디스플레이 끄기 */
  0xD5, 0x80,  /* 클럭 분주 */
  0xA8, 0x3F,  /* 멀티플렉스 비율 = 64 */
  0xD3, 0x00,  /* 표시 오프셋 없음 */
  0x40,        /* 시작 라인 0 */
  0x8D, 0x14,  /* 차지 펌프 켜기 (모듈이 자체 승압) */
  0x20, 0x02,  /* 페이지 주소 모드 */
  0xA1,        /* 좌우 반전 - 일반적인 모듈 배치 기준 */
  0xC8,        /* 상하 반전 */
  0xDA, 0x12,  /* COM 핀 배치 */
  0x81, 0x7F,  /* 밝기 */
  0xD9, 0xF1,  /* 프리차지 */
  0xDB, 0x40,  /* VCOMH */
  0xA4,        /* RAM 내용 표시 */
  0xA6,        /* 정상 표시 (반전 아님) */
  0xAF         /* 디스플레이 켜기 */
};

static uint8_t cmd(uint8_t c) {
  if (!i2c_start(SSD1306_ADDR, 0)) {
    return 0;
  }
  if (!i2c_write(CTRL_CMD)) {
    i2c_stop();
    return 0;
  }
  if (!i2c_write(c)) {
    i2c_stop();
    return 0;
  }
  i2c_stop();
  return 1;
}

uint8_t ssd1306_init(void) {
  uint8_t i;
  g_ready = 0;
  i2c_init();
  for (i = 0; i < sizeof(INIT_SEQ); i++) {
    if (!cmd(pgm_read_byte(&INIT_SEQ[i]))) {
      return 0;
    }
  }
  g_ready = 1;
  ssd1306_clear();
  return 1;
}

/* 커서를 (page, 픽셀 x) 로 옮긴다. */
static uint8_t set_pos(uint8_t page, uint8_t x) {
  if (!cmd((uint8_t)(0xB0 | (page & 0x07)))) {
    return 0;
  }
  if (!cmd((uint8_t)(0x00 | (x & 0x0F)))) {     /* 하위 니블 */
    return 0;
  }
  return cmd((uint8_t)(0x10 | ((x >> 4) & 0x0F))); /* 상위 니블 */
}

void ssd1306_clear(void) {
  uint8_t page, i;

  if (!g_ready) {
    return;
  }
  for (page = 0; page < SSD1306_PAGES; page++) {
    if (!set_pos(page, 0)) {
      return;
    }
    if (!i2c_start(SSD1306_ADDR, 0)) {
      return;
    }
    if (!i2c_write(CTRL_DATA)) {
      i2c_stop();
      return;
    }
    for (i = 0; i < SSD1306_COLS; i++) {
      if (!i2c_write(0x00)) {
        break;
      }
    }
    i2c_stop();
  }
}

void ssd1306_puts(uint8_t page, uint8_t col, const char *s) {
  uint8_t x;

  if (!g_ready || page >= SSD1306_PAGES) {
    return;
  }
  x = (uint8_t)(col * FONT_WIDTH);
  if (!set_pos(page, x)) {
    return;
  }
  if (!i2c_start(SSD1306_ADDR, 0)) {
    return;
  }
  if (!i2c_write(CTRL_DATA)) {
    i2c_stop();
    return;
  }
  while (*s != '\0' && x + FONT_WIDTH <= SSD1306_COLS) {
    uint8_t c = (uint8_t)*s++;
    uint8_t i;
    /* 폰트 범위 밖(소문자 등)은 공백으로 대체한다. */
    if (c < FONT_FIRST_CHAR || c > FONT_LAST_CHAR) {
      c = ' ';
    }
    for (i = 0; i < FONT_WIDTH; i++) {
      if (!i2c_write(pgm_read_byte(&FONT6X8[c - FONT_FIRST_CHAR][i]))) {
        i2c_stop();
        return;
      }
    }
    x = (uint8_t)(x + FONT_WIDTH);
  }
  i2c_stop();
}
```

- [ ] **Step 5: 빌드 검증**

Run: `atmelstudio.exe PEDD.atsln //build Debug //out /tmp/b.log` 후 `grep -E "Build:|error" /tmp/b.log`
Expected: `Build: 4 succeeded`, 오류 없음

- [ ] **Step 6: 커밋**

```bash
git add tools/gen_font.py firmware/common/font6x8.h firmware/common/ssd1306.h firmware/common/ssd1306.c firmware/04_phase4/phase4.cproj
git commit -m "feat: SSD1306 OLED 드라이버와 6x8 폰트 추가"
```

---

### Task 5: button 모듈

**Files:**
- Create: `firmware/common/button.h`
- Create: `firmware/common/button.c`
- Modify: `firmware/04_phase4/phase4.cproj`

**Interfaces:**
- Consumes: 없음
- Produces:
  - `void button_init(void)`
  - `button_event_t button_poll(void)` — 20ms 주기로 호출
  - `typedef enum { BTN_NONE, BTN_SHORT, BTN_LONG } button_event_t`

- [ ] **Step 1: 헤더 작성**

`firmware/common/button.h`:

```c
/*
 * button.h — PD2 택트 스위치. 폴링 + 디바운스.
 *
 * INT0 인터럽트를 쓰지 않는다. 인터럽트는 Timer1 입력 캡처 타이밍에
 * 지터를 줄 수 있고, 측정 정밀도가 이 프로젝트의 핵심이기 때문이다.
 *
 * 스위치는 핀과 GND 사이에 연결하고 내부 풀업을 쓴다. 외부 저항이 없다.
 */

#ifndef BUTTON_H
#define BUTTON_H

#include <stdint.h>

#define BUTTON_POLL_MS   20
#define BUTTON_LONG_MS   2000
#define BUTTON_LONG_TICKS (BUTTON_LONG_MS / BUTTON_POLL_MS)  /* 100 */

typedef enum {
  BTN_NONE  = 0,
  BTN_SHORT = 1,
  BTN_LONG  = 2
} button_event_t;

void button_init(void);

/*
 * BUTTON_POLL_MS 주기로 호출한다.
 * 짧게: 눌렀다 뗀 순간 반환. 길게: 2초를 채우는 순간 반환(떼기 전).
 */
button_event_t button_poll(void);

#endif /* BUTTON_H */
```

- [ ] **Step 2: 구현 작성**

`firmware/common/button.c`:

```c
/*
 * button.c — 디바운스와 짧게/길게 판정
 */

#include <avr/io.h>

#include "button.h"

#define BTN_DDR   DDRD
#define BTN_PORT  PORTD
#define BTN_PIN   PIND
#define BTN_BIT   PD2

/* 눌린 상태로 지난 폴링 횟수. 0이면 떼어져 있음 */
static uint16_t g_held = 0;
/* 길게가 이미 발동했으면 뗄 때 짧게로 또 세지 않는다 */
static uint8_t  g_long_fired = 0;

void button_init(void) {
  BTN_DDR  &= (uint8_t)~(1 << BTN_BIT);  /* 입력 */
  BTN_PORT |= (uint8_t)(1 << BTN_BIT);   /* 내부 풀업 */
  g_held = 0;
  g_long_fired = 0;
}

button_event_t button_poll(void) {
  /* 풀업이므로 눌리면 LOW */
  uint8_t pressed = (BTN_PIN & (1 << BTN_BIT)) ? 0 : 1;

  if (pressed) {
    if (g_held < 0xFFFF) {
      g_held++;
    }
    if (!g_long_fired && g_held >= BUTTON_LONG_TICKS) {
      g_long_fired = 1;
      return BTN_LONG;
    }
    return BTN_NONE;
  }

  /* 떼어진 순간 */
  if (g_held > 0) {
    uint8_t was_long = g_long_fired;
    uint16_t held = g_held;
    g_held = 0;
    g_long_fired = 0;
    /* 1틱(20ms) 이하는 채터링으로 간주해 버린다 */
    if (!was_long && held >= 1) {
      return BTN_SHORT;
    }
  }
  return BTN_NONE;
}
```

- [ ] **Step 3: 빌드 검증**

Run: `atmelstudio.exe PEDD.atsln //build Debug //out /tmp/b.log`
Expected: `Build: 4 succeeded`

- [ ] **Step 4: 커밋**

```bash
git add firmware/common/button.h firmware/common/button.c firmware/04_phase4/phase4.cproj
git commit -m "feat: 택트 스위치 디바운스 모듈 추가"
```

---

### Task 6: 상태머신 (main.c)

**Files:**
- Modify: `firmware/04_phase4/main.c` (Task 0의 스텁을 대체)

**Interfaces:**
- Consumes: `pedd.h`, `uart.h`, `classify.h`, `store.h`, `ssd1306.h`, `button.h`
- Produces: 없음 (최종 실행 파일)

- [ ] **Step 1: 상단 주석과 상수·상태 정의 작성**

`firmware/04_phase4/main.c` 를 다음으로 시작한다:

```c
/*
 * 04_phase4 — 최종 시스템 (온칩 분류 및 통합)
 *
 * 계획서 1.4절 데모 시나리오 / 4.4절 Phase 4 구현.
 * 설계: docs/superpowers/specs/2026-09-03-phase4-design.md
 *
 * 배선 (계획서 회로도 기준)
 *   D8/D9/D10 (PB0~2)  발광 LED R/G/B
 *   D7  (PD7, AIN1)    검출 LED 캐소드
 *   D2  (PD2)          택트 스위치 - GND 사이. 외부 저항 없음
 *   A4/A5 (PC4/PC5)    OLED SDA/SCL
 *   D13 (PB5)          사이클 시간 측정용 토글 (보드 LED 겸용)
 *   D1  (PD1)          UART TX 38400 8N1
 */

#include <avr/io.h>
#include <avr/interrupt.h>
#include <util/delay.h>

#include "pedd.h"
#include "uart.h"
#include "classify.h"
#include "store.h"
#include "ssd1306.h"
#include "button.h"

#define MEASURE_REPEAT  3
#define LEARN_REPEAT    8
#define DEFAULT_THRESHOLD_D2  1600UL

#define TIMING_DDR   DDRB
#define TIMING_PORT  PORTB
#define TIMING_BIT   PB5

typedef enum {
  ST_IDLE = 0,
  ST_MEASURING,
  ST_RESULT,
  ST_LEARN_PROMPT,
  ST_LEARN_RUN,
  ST_SAVED,
  ST_ERROR
} state_t;

static const char *const CLASS_NAMES[CLASSIFY_CLASSES] = {
  "DISTILLED WATER",
  "DYE WATER",
  "MILK"
};

static uint16_t g_centroids[CLASSIFY_CLASSES][CLASSIFY_CHANNELS];
static uint32_t g_threshold = DEFAULT_THRESHOLD_D2;
static uint8_t  g_trained = 0;

/* 마지막 측정 결과 */
static uint32_t g_ticks[4];      /* DARK, R, G, B */
static uint8_t  g_timeout_ch;    /* 0=없음, 1=R, 2=G, 3=B */
static fingerprint_t     g_fp;
static classify_result_t g_res;
```

- [ ] **Step 2: 측정 루틴 작성**

```c
/* 채널 하나를 repeat회 측정해 평균 틱을 낸다. 타임아웃이면 0을 반환한다. */
static uint32_t measure_avg(pedd_channel_t ch, uint8_t repeat) {
  uint32_t sum = 0;
  uint8_t  ok  = 0;
  uint8_t  i;

  for (i = 0; i < repeat; i++) {
    pedd_result_t r = pedd_measure(ch);
    if (r.status == PEDD_OK) {
      sum += r.ticks;
      ok++;
    }
  }
  if (ok == 0) {
    return 0;
  }
  return sum / ok;
}

/* 진행 표시 위치 (문자 단위). DARK R G B 순 */
static const uint8_t SCAN_COL[4] = { 1, 7, 12, 17 };

/* 스캔 시작 화면. 제목만 바꿔 측정과 학습 양쪽에 쓴다. */
static void screen_scan(const char *title, const char *sub) {
  ssd1306_clear();
  ssd1306_puts(0, 0, title);
  ssd1306_puts(1, 0, "---------------------");
  if (sub != 0) {
    ssd1306_puts(2, 0, sub);
  }
  ssd1306_puts(4, 0, "DARK   R    G    B");
  ssd1306_puts(5, 1, "-");
  ssd1306_puts(5, 7, "-");
  ssd1306_puts(5, 12, "-");
  ssd1306_puts(5, 17, "-");
}

/*
 * DARK, R, G, B 를 순서대로 측정한다.
 * PB5를 측정 구간 동안 HIGH로 유지한다 - 오실로스코프로 사이클 시간을
 * 읽는 지점이다 (계획서 4.4.2절).
 * R/G/B 중 타임아웃이 있으면 그 채널 번호를 g_timeout_ch 에 남긴다.
 * DARK 타임아웃은 정상이며 암전류 보정량이 0이 될 뿐이다.
 *
 * 채널 사이에 화면을 갱신하되, PB5 펄스는 채널마다 따로 올렸다 내린다.
 * I2C 통신 시간이 펄스 폭에 섞이면 사이클 처리 시간이 부풀려지기 때문이다.
 * 오실로스코프로는 펄스 4개의 폭을 합산해 읽는다 (계획서 4.4.3절).
 */
static void run_scan(uint8_t repeat) {
  static const pedd_channel_t CH[4] = {
    PEDD_CH_DARK, PEDD_CH_R, PEDD_CH_G, PEDD_CH_B
  };
  uint8_t k;

  for (k = 0; k < 4; k++) {
    TIMING_PORT |= (uint8_t)(1 << TIMING_BIT);
    g_ticks[k] = measure_avg(CH[k], repeat);
    TIMING_PORT &= (uint8_t)~(1 << TIMING_BIT);
    /* 화면 갱신은 펄스 밖에서 한다. */
    ssd1306_puts(5, SCAN_COL[k], (g_ticks[k] == 0) ? "XX" : "OK");
  }

  g_timeout_ch = 0;
  if (g_ticks[1] == 0) {
    g_timeout_ch = 1;
  } else if (g_ticks[2] == 0) {
    g_timeout_ch = 2;
  } else if (g_ticks[3] == 0) {
    g_timeout_ch = 3;
  }

  g_fp = classify_fingerprint(g_ticks[0], g_ticks[1], g_ticks[2], g_ticks[3]);
}
```

- [ ] **Step 3: 출력 루틴 작성 (UART + OLED)**

```c
/* 21자 화면 폭에 맞춘 우측 정렬 숫자 출력용 */
static void fmt_u32(char *buf, uint8_t width, uint32_t v) {
  uint8_t i = width;
  buf[width] = '\0';
  while (i > 0) {
    i--;
    buf[i] = (char)('0' + (v % 10));
    v /= 10;
    if (v == 0) {
      break;
    }
  }
  while (i > 0) {
    i--;
    buf[i] = ' ';
  }
}

static void log_uart(void) {
  uart_puts("seq,DARK,R,G,B,n0,n1,n2,cls,d2");
  uart_newline();
  uart_put_u32(g_ticks[0]); uart_putc(',');
  uart_put_u32(g_ticks[1]); uart_putc(',');
  uart_put_u32(g_ticks[2]); uart_putc(',');
  uart_put_u32(g_ticks[3]); uart_putc(',');
  uart_put_u32(g_fp.n[0]);  uart_putc(',');
  uart_put_u32(g_fp.n[1]);  uart_putc(',');
  uart_put_u32(g_fp.n[2]);  uart_putc(',');
  if (g_res.cls < 0) {
    uart_puts("UNKNOWN");
  } else {
    uart_puts(CLASS_NAMES[g_res.cls]);
  }
  uart_putc(',');
  uart_put_u32(g_res.d2);
  uart_newline();
}

static void screen_result(void) {
  char buf[8];

  ssd1306_clear();
  ssd1306_puts(0, 0, "RESULT:");
  ssd1306_puts(0, 9, (g_res.cls < 0) ? "UNKNOWN" : CLASS_NAMES[g_res.cls]);
  ssd1306_puts(1, 0, "---------------------");

  ssd1306_puts(2, 0, "R");
  fmt_u32(buf, 7, pedd_ticks_to_us(g_ticks[1]));
  ssd1306_puts(2, 3, buf);
  ssd1306_puts(2, 11, "US");

  ssd1306_puts(3, 0, "G");
  fmt_u32(buf, 7, pedd_ticks_to_us(g_ticks[2]));
  ssd1306_puts(3, 3, buf);
  ssd1306_puts(3, 11, "US");

  ssd1306_puts(4, 0, "B");
  fmt_u32(buf, 7, pedd_ticks_to_us(g_ticks[3]));
  ssd1306_puts(4, 3, buf);
  ssd1306_puts(4, 11, "US");

  ssd1306_puts(5, 0, "DARK");
  fmt_u32(buf, 7, pedd_ticks_to_us(g_ticks[0]));
  ssd1306_puts(5, 5, buf);
  ssd1306_puts(5, 13, "US");

  ssd1306_puts(6, 0, "DIST");
  fmt_u32(buf, 5, g_res.dist);
  ssd1306_puts(6, 5, buf);
  ssd1306_puts(6, 11, "THR");
  fmt_u32(buf, 5, classify_isqrt(g_threshold));
  ssd1306_puts(6, 15, buf);
}

static void screen_idle(void) {
  ssd1306_clear();
  ssd1306_puts(0, 0, "LED PEDD ANALYZER");
  ssd1306_puts(1, 0, "---------------------");
  if (g_trained) {
    ssd1306_puts(3, 0, "READY");
    ssd1306_puts(5, 0, "SHORT: MEASURE");
    ssd1306_puts(6, 0, "LONG : LEARN");
  } else {
    ssd1306_puts(3, 0, "NOT TRAINED");
    ssd1306_puts(5, 0, "HOLD BTN 2S TO LEARN");
  }
}

static void screen_error(void) {
  ssd1306_clear();
  ssd1306_puts(0, 0, "ERROR");
  ssd1306_puts(1, 0, "---------------------");
  if (g_timeout_ch == 1) {
    ssd1306_puts(3, 0, "TIMEOUT: R");
  } else if (g_timeout_ch == 2) {
    ssd1306_puts(3, 0, "TIMEOUT: G");
  } else if (g_timeout_ch == 3) {
    ssd1306_puts(3, 0, "TIMEOUT: B");
  } else {
    ssd1306_puts(3, 0, "LOW SIGNAL");
  }
  ssd1306_puts(5, 0, "CHECK LED POLARITY");
  ssd1306_puts(6, 0, "SHORT: BACK");
}
```

- [ ] **Step 4: 상태머신 본체 작성**

```c
int main(void) {
  state_t state = ST_IDLE;
  uint8_t learn_idx = 0;
  uint32_t learn_acc[CLASSIFY_CLASSES][CLASSIFY_CHANNELS];

  TIMING_DDR |= (uint8_t)(1 << TIMING_BIT);
  uart_init();
  pedd_init();
  button_init();
  ssd1306_init();   /* 실패해도 계속 진행한다. UART 로깅은 살아 있어야 한다. */
  sei();

  g_trained = store_load(g_centroids, &g_threshold);
  if (!g_trained) {
    g_threshold = DEFAULT_THRESHOLD_D2;
  }
  screen_idle();

  for (;;) {
    button_event_t ev = button_poll();
    _delay_ms(BUTTON_POLL_MS);

    switch (state) {
      case ST_IDLE:
        if (ev == BTN_SHORT && g_trained) {
          screen_scan("MEASURING...", 0);
          run_scan(MEASURE_REPEAT);
          g_res = classify_match(&g_fp, (const uint16_t (*)[CLASSIFY_CHANNELS])g_centroids, g_threshold);
          log_uart();
          if (g_timeout_ch != 0 || g_fp.status != CLASSIFY_OK) {
            screen_error();
            state = ST_ERROR;
          } else {
            screen_result();
            state = ST_RESULT;
          }
        } else if (ev == BTN_LONG) {
          learn_idx = 0;
          state = ST_LEARN_PROMPT;
          ssd1306_clear();
          ssd1306_puts(0, 0, "LEARN 1/3");
          ssd1306_puts(1, 0, "---------------------");
          ssd1306_puts(3, 0, CLASS_NAMES[0]);
          ssd1306_puts(5, 0, "SHORT: MEASURE");
          ssd1306_puts(6, 0, "LONG : CANCEL");
        }
        break;

      case ST_RESULT:
      case ST_ERROR:
        if (ev == BTN_SHORT) {
          screen_idle();
          state = ST_IDLE;
        }
        break;

      case ST_LEARN_PROMPT:
        if (ev == BTN_LONG) {
          screen_idle();
          state = ST_IDLE;
        } else if (ev == BTN_SHORT) {
          uint8_t k;
          screen_scan("LEARNING", CLASS_NAMES[learn_idx]);
          run_scan(LEARN_REPEAT);
          log_uart();
          if (g_timeout_ch != 0 || g_fp.status != CLASSIFY_OK) {
            screen_error();
            state = ST_ERROR;
            break;
          }
          for (k = 0; k < CLASSIFY_CHANNELS; k++) {
            learn_acc[learn_idx][k] = g_fp.n[k];
          }
          learn_idx++;
          if (learn_idx >= CLASSIFY_CLASSES) {
            uint8_t c;
            for (c = 0; c < CLASSIFY_CLASSES; c++) {
              for (k = 0; k < CLASSIFY_CHANNELS; k++) {
                g_centroids[c][k] = (uint16_t)learn_acc[c][k];
              }
            }
            g_threshold = DEFAULT_THRESHOLD_D2;
            store_save((const uint16_t (*)[CLASSIFY_CHANNELS])g_centroids, g_threshold);
            g_trained = 1;
            ssd1306_clear();
            ssd1306_puts(0, 0, "SAVED TO EEPROM");
            ssd1306_puts(1, 0, "---------------------");
            ssd1306_puts(3, 0, "3 CLASSES STORED");
            state = ST_SAVED;
          } else {
            ssd1306_clear();
            ssd1306_puts(0, 0, (learn_idx == 1) ? "LEARN 2/3" : "LEARN 3/3");
            ssd1306_puts(1, 0, "---------------------");
            ssd1306_puts(3, 0, CLASS_NAMES[learn_idx]);
            ssd1306_puts(5, 0, "SHORT: MEASURE");
            ssd1306_puts(6, 0, "LONG : CANCEL");
          }
        }
        break;

      case ST_SAVED:
        if (ev == BTN_SHORT) {
          screen_idle();
          state = ST_IDLE;
        }
        break;

      default:
        state = ST_IDLE;
        break;
    }
  }
}
```

- [ ] **Step 5: 빌드 및 메모리 확인**

Run:
```bash
cd "C:/Users/hwali/OneDrive/Desktop/COSS 반도체 경진대회/firmware"
"/c/Program Files (x86)/Atmel/Studio/7.0/atmelstudio.exe" PEDD.atsln //build Debug //out /tmp/b.log
grep -E "Memory Usage|Build:" /tmp/b.log
```
Expected: `Build: 4 succeeded`, phase4의 Program Memory Usage 가 **12~18%** 범위

18%를 크게 넘으면 `float`가 어딘가로 링크되었을 가능성이 높다.
`avr-nm --size-sort Debug/phase4.elf | tail -20` 으로 확인한다.

- [ ] **Step 6: 커밋**

```bash
git add firmware/04_phase4/main.c
git commit -m "feat: Phase 4 상태머신 구현"
```

---

### Task 7: 통합 정리와 문서 갱신

**Files:**
- Modify: `firmware/README.md`
- Create: `docs/superpowers/plans/2026-09-03-phase4-bringup.md`

**Interfaces:**
- Consumes: Task 0~6 전체
- Produces: 없음

- [ ] **Step 1: 전체 테스트 재실행**

Run: `sh tools/run_host_tests.sh`
Expected: `== 실패 0건 ==`

Run: `atmelstudio.exe PEDD.atsln //build Debug //out /tmp/b.log`
Expected: `Build: 4 succeeded, 0 failed`

- [ ] **Step 2: README에 Phase 4 절 추가**

`firmware/README.md`의 "3. 단계별 진행" 아래에 추가:

```markdown
### 04_phase4 — 최종 시스템

PC 없이 동작한다. 배선은 phase2에 스위치(D2)와 OLED(A4/A5)를 추가한 것이다.

| 조작 | 동작 |
|---|---|
| 짧게 | 측정 후 판정 |
| 길게 (2초) | 학습 모드 - 3종을 순서대로 측정해 EEPROM에 저장 |

처음 켜면 `NOT TRAINED`가 뜬다. 길게 눌러 학습을 먼저 해야 판정이 된다.

측정값은 OLED와 UART로 동시에 나간다. OLED가 없어도 UART 로깅은 계속된다.
```

- [ ] **Step 3: 하드웨어 브링업 체크리스트 작성**

`docs/superpowers/plans/2026-09-03-phase4-bringup.md`:

```markdown
# Phase 4 하드웨어 브링업 순서

부품 도착 후 이 순서대로 진행한다. 한 번에 다 연결하면 어디가 문제인지 모른다.

- [ ] 1. `01_blink` 업로드 → 보드 L LED 1초 점멸
- [ ] 2. 스위치만 연결(D2-GND) → phase4 업로드 → 누를 때 UART에 로그
- [ ] 3. OLED만 연결(A4/A5/5V/GND) → 화면에 `LED PEDD ANALYZER`
      - 안 나오면 `SSD1306_ADDR` 을 0x3D로 바꿔 재시도
- [ ] 4. LED 4개 연결 → `02_phase1` 로 측정값 확인
- [ ] 5. phase4 전체 → 학습 3종 → 판정
- [ ] 6. PB5(D13) 펄스 폭 측정 → 사이클 시간 기록 (계획서 4.4.3)
```

- [ ] **Step 4: 커밋**

```bash
git add firmware/README.md docs/superpowers/plans/2026-09-03-phase4-bringup.md
git commit -m "docs: Phase 4 사용법과 브링업 체크리스트 추가"
```

---

## 실험 후 확정할 상수

부품 도착 후 Phase 1~2 데이터가 나오면 조정한다. 스펙 12절과 동일하다.

| 상수 | 위치 | 초기값 |
|---|---|---|
| `THRESHOLD_D2` | `04_phase4/main.c` | 1600 |
| `CLASSIFY_MIN_SIGNAL` | `common/classify.h` | 3000 |
| `MEASURE_REPEAT` | `04_phase4/main.c` | 3 |
| `LEARN_REPEAT` | `04_phase4/main.c` | 8 |
| `CLASSIFY_K` | `common/classify.h` | 1e9 |
| `SSD1306_ADDR` | `common/ssd1306.h` | 0x3C |
