jms1005/coss-led-pedd-analyzer/LED_PEDD_계획서_최종본.pdf

## LED 다파장 재이용 광검출 기반

## 저비용 액체 광학 분석기 개발

연구 계획서 (Research & Methodology Plan)

2026 COSS 차세대반도체MCU 응용경진대회출품 프로젝트

개정일: 2026년 9 월 (제 2 판)

Abstract

본 계획서는 LED(발광 다이오드)를 광검출 소자로 활용하는 Paired Emitter –Detector

Diode (PEDD) 원리를 기반으로, RGB 다파장 광원을 이용해 액체 시료의 다차원 광학

지문(optical fingerprint) 을 획득하고, 측정·보정·정규화·분류의 전 과정을 단일 MCU

내부에서수행하는저비용 임베디드액체 분석 시스템의연구 방법론을기술한다. 기존 PEDD

선행 연구(Dublin City University, Diarmuid Diamond 그룹 등)는 대부분 1~2개 LED 를

이용한 단일 분석물(탁도, 당도 등) 측정과 PC 기반 후처리에국한되어있었다. 본 프로젝트는

(i) RGB 다파장광원 기반의범용 광학 지문 추출과(ii) 보정·분류 전 과정의MCU 내장을핵심

차별점으로 설정한다. 검출 소자로는 전용 포토다이오드 대신 LED 를 역방향 바이어스하여

사용하며, 방전 시간 측정은 ATmega328P 의 Analog Comparator 와 Timer1 Input

Capture 를 이용해하드웨어적으로처리한다. 본 문서는시스템구조, 실험 절차, 필요 장비 및

구매 목록, 실험 수행 방법을 중심으로서술한다.

Contents

## 1 서론

### 1.1 연구 배경

액체의광학적특성(투과율, 산란도, 흡광도등)을 이용한수질·농도 분석은전통적으로전용 광검출

소자(포토다이오드, 포토트랜지스터)와 아날로그신호처리회로를필요로한다. 이러한구성은

부품 수 증가, 비용 상승, 그리고상대적으로복잡한아날로그프론트엔드설계를요구한다.

LED 는 본질적으로p-n 접합 반도체소자이며, 순방향바이어스시 발광하지만역방향바이어스

상태에서는포토다이오드와동일한원리로입사광에비례하는광전류(photocurrent) 를

생성한다. 이 원리를이용하면전용 광검출소자 없이 LED 자체를검출 소자로활용할수 있다.

### 1.2 연구 목적

본 연구는다음을목적으로한다.

(1) LED 의 광검출소자로서의재현성과신뢰성을실험적으로검증한다.
(2) RGB 다파장 광원을 이용하여 단일 파장 측정으로는 얻을 수 없는 다차원 광학 지문을

추출한다.

(3) 보정(calibration), 정규화(normalization), 분류(classification)의 전 과정을 MCU

내부에서수행하는임베디드파이프라인을구현한다.

(4) 방전 임계점 검출을 소프트웨어폴링이 아닌 MCU 내부 하드웨어(Analog Comparator +

Timer1 Input Capture) 로 처리하여, 선행 연구가 지적한 펌웨어 타이밍 의존성 문제를

완화한다.

(5) 위 결과를 바탕으로 전통적 포토다이오드 기반 구성 대비 경제성 및 자원 효율성을

정량적으로비교한다.

### 1.3 연구 질문

저비용LED 를 광검출소자로사용하는RGB 다파장구성이, 액체 시료의광학적

차이를반복 가능하게구별할수 있는 다차원신호(광학 지문)를 생성할수 있는가?

그리고이 전체 처리 과정(측정·보정·분류)을 단일 8 비트 MCU 상에서실시간으로

수행할수 있는가?

### 1.4 최종 데모 시나리오

본 연구의최종 산출물은다음 시나리오로동작하는단일 보드 시스템이다. 본 시나리오는이후

모든 장의 설계 기준점이되며, 필요 핀 수·타이머구성·부품 목록이여기에서도출된다.

1. 사용자가시료가담긴 큐벳을차광 챔버에삽입한다.
2. 측정 시작 버튼을누른다.
3. MCU 가 Red → Green → Blue 순으로발광 LED 를 하나씩점등한다.
4. 각 파장에대해 검출 LED 의 역바이어스충전–방전 시간을Timer1 으로 측정한다.
5. 3 개 채널의측정값으로광학 지문 벡터 [R, G, B] 를 구성한다.
6. MCU 내부에서암전류보정·정규화를수행한뒤 최근접중심점분류를실행한다.
7. 판정결과를출력한다. 기본출력은UART 시리얼이며, 최종시연시에는LCD/OLED 모듈에

시료 종류를표시한다.

출력 장치 구성은단계적으로확장한다. 개발 및 실험 단계에서는원시 데이터로깅이중요하므로

UART 시리얼 출력을 기본으로 사용하고, LCD/OLED 와 측정 시작 버튼은 최종 시연용으로

추가한다. 이는 경진대회요강이요구하는“디스플레이, 스위치등 외부 부품을MCU 와 연결하여

데이터를주고받는회로”에 해당한다.

## 2 선행 연구 검토

### 2.1 PEDD (Paired Emitter –Detector Diode) 원리

LED 를 광검출소자로사용하는접근은1980년대 Forrest Mims 에 의해 처음 제안되었으며,

이후 PEDD(Paired Emitter–Detector Diode)라는 명칭으로학술적으로체계화되었다.

대표적으로Dublin City University 의 Diarmuid Diamond 연구 그룹(Cormac Fay 등)이

2008년경부터다음과같은 응용을발표하였다.

- ISO 7027 표준과 비교 검증된 수질 탁도(turbidity) 측정 PEDD 시스템 — 기존

포토다이오드기반시스템대비부품수 감소, 약 18% 비용절감, 소비전력1% 미만, 더 높은

민감도를보고함.

- 890 nm 파장의 2-LED PEDD 센서를 이용한 콜라 음료 내 자당(sucrose, schlieren 굴절

효과 기반)과 인산염(phosphate, 탁도 기반) 동시 측정.

- 미세유체lab-on-a-disc 장치에서의pH 및 탁도 동시 모니터링.
- PEDD 측정 정확도에 미치는 펌웨어 타이밍 설계의 영향을 다룬 연구 — 소프트웨어적

타이밍 처리 방식만으로 검출 성능이 최대 67% 차이가 나며, 보정 후 측정 불일치율을

23%에서 0.18%까지 낮출 수 있음을보고함.

### 2.2 선행 연구의 한계 및 본 연구의 차별점

기존 PEDD 문헌을검토한결과, 다음과같은 공백을확인하였다.

(a) 대부분의PEDD 연구는1~2개의 LED 만을 사용하며, 단일 분석물(탁도 또는 특정 성분)에

최적화되어 있다. 3 개 이상의 파장 채널로 구성한 광학 지문을 이용해 액체를 범용적으로

분류하는연구는보고된바가 거의 없다.

(b) 대다수 PEDD 연구는 데이터를 PC 로 전송하여 후처리·분류하며, 보정·정규화·분류 전

과정을MCU 내부에서수행하는사례는드물다.

(c) 펌웨어 타이밍 설계가 측정 정확도에 미치는 영향이 보고되어 있으나, 이를 MCU 내부

하드웨어(비교기·입력 캡처)로 회피하는 구현을 다파장 환경에서 체계적으로 다룬 연구는

확인되지않았다.

따라서본 연구는다음을핵심 차별점으로설정한다.

전용 포토다이오드 대신 LED 를 광검출 소자로 활용하고, RGB 다파장 광원을

이용하여 액체의 다차원 광학 지문을 획득하며, 측정·보정·분류의 전 과정을 저사양

MCU 내부에서 수행하는 저비용 액체 분석 시스템을 구현한다.

아울러방전 임계점판정을소프트웨어폴링이아닌 Analog Comparator 와 Timer1 Input

Capture 로 처리함으로써, 참고문헌[4]가 보고한펌웨어타이밍설계 의존성을하드웨어수준에서

완화한다는점을 부가적기여로둔다.

## 3 연구 방법론

### 3.1 시스템 구조와 광학 경로

본 시스템의신호 흐름은다음과같다.

ATmega328P → RGB 발광 LED → 액체 시료 → 검출 LED → Analog Comparator → Timer1 Input

Capture → 보정·분류 → UART / LCD 출력

[그림 1] 시스템 블록도 — 삽입 예정. 위 흐름을블록 다이어그램으로작성하여본 위치에

삽입한다. 블록은(1) MCU, (2) RGB 발광부, (3) 광학 경로(차광 챔버 + 큐벳), (4) 검출부, (5) 신호

처리부(Comparator·Timer1), (6) 출력부로구성한다.

광학 경로는발광 LED 와 검출 LED 가 시료 용기를사이에두고 서로 마주보는

투과(transmission) 배치를기본으로한다. 발광부와검출부는역할을분리하며, 각 발광 LED 는

MCU GPIO 로 순차 제어된다. 한 번에 하나의파장만점등하므로채널 간 광학적간섭이발생하지

않는다.

발광·검출 겸용 구조는 본 연구의 예선 구현 범위에서 제외한다. LED 하나를발광과검출에모두

사용하려면LED 당 2 개의 GPIO 와 모드 전환 로직이필요하여구현 난이도와핀 사용량이크게

증가한다. 제한된개발 기간 내에서는측정의안정성과시스템완성도를우선하며, 겸용 구조와

이에 따른 핀 수 최적화는8 장에서향후 개선 방향으로다룬다.

### 3.2 광검출 원리 및 측정 방식

본 연구는아날로그광전류증폭(트랜스임피던스증폭기, TIA) 방식이아닌, 정전용량 방전 시간

측정(capacitive discharge / timing) 방식을 채택한다. 그 절차는다음과같다.

1. 검출 LED 를 역방향으로 바이어스하여 접합 정전용량을충전한다. 이를 위해 검출 LED 의

캐소드를 MCU 의 GPIO 핀에, 애노드를 접지(GND)에 연결하고, 해당 핀을 출력 모드에서

HIGH 로 구동한다. 이때 캐소드전위가애노드보다높아져역방향바이어스가성립한다.

2. 해당 핀을 즉시 입력(input, 하이 임피던스) 모드로전환하고풀업을비활성화한다.
3. 접합에 축적된 전하는 입사광에 의해 생성되는 광전류를 통해 방전되며, 핀 전압이 기준

임계값에도달할때까지걸리는시간을Timer1 으로 측정한다.

4. 입사광이강할수록방전 속도가빨라지므로, 방전 시간은광량과반비례관계를가진다.

방전은광전류라는거의 일정한전류에의해 일어나므로, 전압은시간에대해 지수함수가아닌

선형에 가까운 기울기로 감소한다. 따라서방전 시간은광량의역수에비례하는값으로해석할수

있다.

이 방식은별도의아날로그프론트엔드(TIA, 정밀 증폭기)를 필요로하지 않으며, LED 와 MCU 의

디지털핀만으로구현이가능하다는점에서경진대회평가 항목 중 경제성측면에서강점을가진다.

다만 측정 정확도가임계값판정의안정성에의존하므로, 본 연구에서는논리 문턱값(전원 전압과

온도에따라 변동)을 사용하는대신 내부 1.1 V 밴드갭 기준 전압과 Analog Comparator 를

사용한다. 구체적인설정은3.6 절과 6.2 절에서서술한다.

### 3.3 다파장 배열 설계 원칙

- 각 LED 는 자신의 발광 파장과 같거나 그보다 짧은 파장에 상대적으로민감하게 반응하는

경향을가지므로, 검출 LED 의 파장 선택 시 이 특성을고려한다.

- 발광부를구성하는LED 파장들은가시광선스펙트럼전반에걸쳐최대한분산시켜, 채널간

정보 중복을최소화한다. 초기 구성은적색·녹색·청색 3 파장으로한다.

- 각 파장 채널이 실제로시료 간 판별에유의미한정보를추가하는지는4.2 절의 실험을통해

단계적으로 검증한다. Red → Green → Blue 순으로 채널을 하나씩 추가하며 판별력

증가분을확인하고, 기여도가낮은파장은최종 구성에서제외하거나낮은우선순위로둔다.

- RGB 3채널만으로시료군 분리가 충분하지않은 경우에 한하여 근적외선(IR) 채널 추가를

검토한다. 채널 추가는 측정 사이클 시간과 핀 사용량을 함께 증가시키므로판별력 개선이

확인된경우에만채택한다.

발광 LED 는 개별 소자를사용한다. RGB 일체형패키지는캐소드또는 애노드가공통이어서

채널별독립 제어와광학 경로 분리가제약되므로, 초기 구현에서는배선이단순하고파장 분리가

명확한개별 LED 구성을채택한다.

### 3.4 ATmega328P 선정 근거

본 연구의최종 MCU 로 Microchip ATmega328P 를 선정한다. 선정 기준과근거는다음과

같다.

선정 기준 | 요구 사항 | ATmega328P 사양 및 적합성
GPIO 수 | 광학부4 핀 + 버튼 1 + UART 2 + 표시장치(최대 약 12핀) | 23 개 I/O 제공. 충분한여유를확보하면서도 과잉 사양이아님
타이머 | 방전 시간을μs 분해능으로 측정할16비트 타이머 | Timer1 16비트, 프리스케일러/8에서 500 ns 분해능
임계점검출 | 전원·온도에안정한기준 전압과하드웨어시각 기록

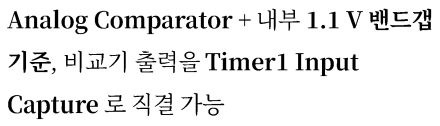
[picture p8: figure]
Analog Comparator + 내부 1.1 V 밴드갭; 기준, 비교기출력을Timer1 Input; Capture 로 직결 가능

프로그램메모리 | 측정·보정·분류 펌웨어 | Flash 32 KB

선정 기준 | 요구 사항 | ATmega328P 사양 및 적합성
데이터메모리 | 측정 버퍼 및 기준 중심점(centroid) 저장 | SRAM 2 KB, EEPROM 1 KB (centroid 비휘발저장에활용)
개발 환경 | 경진대회규정상Microchip Studio 사용, 라이브러리 비의존

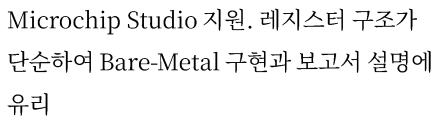
[picture p9: figure]
Microchip Studio 지원. 레지스터구조가; 단순하여Bare-Metal 구현과보고서설명에

비용 | 경제성평가 항목 대응 | IC 단품 약 5,000원 수준으로조달 가능

특히 Analog Comparator 와 Timer1 Input Capture 의 조합은 본 연구의측정 방식에직접

대응하는하드웨어이다. 방전 임계점을소프트웨어폴링으로판정하면인터럽트지연과논리

문턱값변동이그대로측정 오차가되지만, 비교기출력을입력 캡처 트리거로사용하면임계점

도달 순간의타이머값이 하드웨어에의해 기록되어이러한오차 요인이제거된다. 이는 참고문헌

[4]가 보고한펌웨어타이밍의존성문제에대한 직접적인대응이며, 동시에경진대회평가 항목 중

“하드웨어와소프트웨어의배분”에 부합한다.

STM32 계열은ADC 분해능과연산 성능에서우위에있으나, 본 시스템은ADC 를 사용하지않고

요구 핀 수와 연산량이작아 그 이점을활용할여지가적다. 반면 부품 단가와레지스터구조의

복잡도가증가하므로, 경제성과설명 용이성을우선하여ATmega328P를 채택하였다.

### 3.5 GPIO 핀 사용량 분석

경진대회는MCU 사용 핀 수를 시스템비용에반영하므로, 기능별핀 사용량을다음과같이

산정한다.

기능 | 핀 | 개수 | 비고
발광부(Red) | PB0 | 1 | 순방향구동, 전류 제한 저항 직렬
발광부(Green) | PB1 | 1 | 동일
발광부(Blue) | PB2 | 1 | 동일
검출부 | PD7 (AIN1) | 1 | Analog Comparator 음극 입력으로 고정
광학 측정부 소계 | — | 4 | 핵심 기능 구현에 필요한 최소 구성
측정 시작 버튼 | PD2 등 | 1 | 내부 풀업 사용, 외부 저항 불필요
UART 출력 | PD0 / PD1 | 2 | 개발·실험 단계 기본 출력

기능 | 핀 | 개수 | 비고
표시 장치 (선택) | I²C 2 핀 또는 병렬 | 2~6 | 최종 시연용LCD/OLED
합계 (최소 / 최대) | — | 5 / 13 | 표시 장치 구성에따라 변동

검출 LED 가 PD7 에 고정되는이유는ATmega328P의 Analog Comparator 음극 입력(AIN1)이

해당 핀에 배정되어있기 때문이다. 따라서회로도작성 시 이 핀은 다른 용도로배정할수 없다.

광학 측정 기능을4 핀으로구현하는것은 발광·검출 겸용 구조 대비 유리하다. 겸용 구조에서는

LED 하나당애노드·캐소드양쪽을GPIO 에 연결해야하므로3 파장 구성 시 6~8핀이 필요하다.

다만 겸용 구조는검출 소자를별도로두지 않아도되므로, 파장 수가 많아질수록부품 수 측면의

이점이생긴다. 이 트레이드오프는8 장에서향후 과제로정리한다.

### 3.6 Timer1 · Overflow · Timeout 설계

방전 시간 측정에는16비트 타이머인Timer1 을 사용한다. 16 MHz 동작 기준 프리스케일러별

시간 분해능과1 회 계수 범위는다음과같다.

프리스케일러 | 타이머 클럭 | 시간 분해능 | 1회 오버플로우까지
/8 (채택) | 2 MHz | 500 ns | 32.8 ms
/64 | 250 kHz | 4 μs | 262 ms
/256 | 62.5 kHz | 16 μs | 1.05 s
/1024 | 15.6 kHz | 64 μs | 4.19 s

프리스케일러는 /8 로 확정한다. 측정 범위는아래의Overflow Counter 가 확장하므로,

프리스케일러선정에서계수 범위는제약 조건이되지 않는다. 따라서선택 기준은시간 분해능만

남으며, 이 기준에서/8이 우월하다. Phase 1의 실측은이 선택을*확인*하는 절차이지결정하는

절차가아니며, 실측으로결정할값은 아래의Timeout 임계값이다.

### 3.6.1 Overflow Counter

암전류조건에서의방전은광전류가매우 작아 수 초 이상 소요될수 있으며, 이는 Timer1 의 1 회

계수 범위인32.8 ms를 크게 초과한다. 따라서다음 구조를Phase 1 부터 구현한다.

1. Timer1 Overflow Interrupt 를 활성화하고, ISR 에서 소프트웨어오버플로우카운터를1

증가시킨다.

2. 최종 방전 시간은총 계수 = ICR1 + (오버플로우 횟수 × 65536) 으로 산출한다.
3. 16 비트 오버플로우 카운터를 사용할 경우 총 측정 범위는 약 35 분에 달하므로, 500 ns

분해능을유지한채 밝은 조건과암전류조건을하나의설정으로모두 포괄할수 있다.

Phase 1의 첫 측정 항목이암전류기준 방전 시간이므로, 오버플로우처리 없이는Phase 1 자체를

수행할수 없다. 이 기능을후반 단계로미루지않고 최초 구현에포함하는이유가여기에있다.

### 3.6.2 Timeout 처리

검출 LED 가 손상되었거나광 경로가완전히차단된경우 방전이사실상진행되지않아 프로그램이

무한 대기할수 있다. 이를 방지하기위해 사전에설정한최대 측정 시간을초과하면측정을

중단하고TIMEOUT 상태를반환한다. Timeout 값은 Phase 1에서 측정한암전류조건 방전 시간

분포를근거로결정하며, 예비 목표는1~2초 범위로둔다. Timeout 이 발생한측정은통계에서

제외하고별도로기록한다.

### 3.7 Bare-Metal 구현 범위

경진대회요강은Arduino IDE 및 라이브러리사용을금지하고MCU 레지스터를직접

read/write 하는 방식에높은 점수를부여한다. 이에 따라 개발 환경은Microchip Studio 를

사용하며, 핵심 측정 기능은다음과같이 레지스터직접 제어로구현한다.

구현 항목 | 직접 제어 대상 | 역할
GPIO 방향 전환 | DDRD, DDRB | 검출 핀의 출력(충전) ↔ 입력(방전) 전환
GPIO 출력 제어 | PORTB, PORTD | 발광 LED 점등/소등, 충전 구동, 풀업 비활성화
비교기설정 | ACSR, ADCSRB, DIDR1 | 밴드갭기준 선택, 입력 캡처 연결, 버퍼 차단
타이머설정 | TCCR1A, TCCR1B, TCNT1 | 프리스케일러설정, 캡처 에지 선택, 카운터 초기화
캡처 값 읽기 | ICR1 | 임계점도달 시각의하드웨어기록값취득
인터럽트제어 | TIMSK1, TIFR1 | 캡처·오버플로우인터럽트활성화및 플래그 관리
UART 출력 | UBRR0, UCSR0B, UDR0 | 측정 로그 전송

ISR 과 메인 루프의역할은다음과같이 분리한다. ISR 은 시각 기록과 카운터 갱신만 수행하고,

평균·표준편차계산, 보정 연산, 분류 판정은모두 메인 루프에서처리한다. ISR 내부의연산량을

최소화해야인터럽트지연이측정값에개입하지않기 때문이다.

구현 메모. 실제 코딩 시 다음 두 가지를확인한다. 첫째, 측정 시작 전 ICF1 플래그를반드시

클리어한다(AVR에서는해당 비트에1 을 기록하여클리어). 이전 측정의캡처 플래그가남아

있으면타이머시작 즉시 트리거되어방전 시간이0 으로 기록된다. 둘째, 캡처가오버플로우

경계에걸리는경우를보정한다. ICR1 값이 매우 작은데TOV1 플래그가아직 처리되지않은

상태라면오버플로우가캡처보다먼저 발생한것이므로오버플로우횟수를1 증가시켜계산한다.

이 보정을누락하면32.8 ms 단위의이상값이간헐적으로섞여 변동계수통계가왜곡된다.

### 3.8 보정 및 온칩 분류

### 3.8.1 보정 및 정규화

- 암전류(dark current) 보정: 발광 LED 가 모두 꺼진 상태에서 검출 LED 의 기준 방전

시간을측정하여채널별오프셋으로저장한다.

- LED 개체차 보정: 동일 사양의 LED 라도 개체 간 특성 편차가 존재하므로, 알려진 기준

시료(증류수)에 대한 각 채널의반응값을기준으로정규화한다.

- 환경광 억제: 각 파장측정전후로발광LED 를켠상태와끈 상태의검출값을비교(차분)하여

외부광영향을제거한다.

보정식은사전에고정하지않는다. 다음 절차로실험 결과에근거하여선택한다.

1. 원시 방전 시간 데이터의분포와채널 간 상관을분석한다.
2. 기준 시료(증류수)를 반복 측정하여세션 간 드리프트크기를확인한다.
3. 오프셋차감 방식, 기준값대비 비율(ratio) 방식, 발광 ON/OFF 차분 방식 등 후보 보정식을

동일 데이터에적용한다.

4. 각 방식의 반복 측정 표준편차와시료군 간 분리도를 비교하여 재현성이 가장 높은 방식을

최종 채택한다.

### 3.8.2 온칩(On-MCU) 분류 방법

1차 분류기로는메모리및 연산량이매우 낮은 최근접 중심점(nearest -centroid) 비교 방식을

채택한다. 각 기준 시료군에대해 사전 저장된다차원기준 지문(centroid)과 신규 측정값간의

거리를계산하여가장 가까운그룹으로분류한다.

입력과출력의예시는다음과같다. 입력은보정된방전 시간 3 채널 벡터이며, 출력은사전 정의된

시료군라벨이다.

입력 [R, G, B] = [1240, 980, 1510] → 출력 증류수 / 착색수 / 탁도수 중 1

이 방식은다음과같은 이유로선택되었다.

- 저사양AVR 계열 MCU 에서도부동소수점연산 없이 고정소수점으로구현 가능하다.
- 분류 판단의근거가명확하여보고서에서설명하기용이하다.
- 거리 비교에서 제곱근 연산을 생략할 수 있다. 유클리드거리의 대소 관계는 제곱값의대소

관계와 동일하므로, 제곱근을취하지 않고 제곱 거리만 비교해도분류 결과가 같다. 이로써

연산량과코드 크기를추가로절감할수 있다.

- 기준 중심점은 채널 수 × 시료군 수 × 4 바이트 규모로, 3 채널 3 분류 기준 36바이트에

불과하다. EEPROM 에 저장하면전원을껐다 켜도 재학습이불필요하다.

- 추후 시간이허락할경우 소형 결정트리(decision tree) 등으로확장할여지를남겨둔다.

## 4 실험 과정 서술 (Experimental Procedures)

본 장에서는연구를4 단계(Phase)로 나누어각 단계의목적, 재료, 절차, 성공 기준을서술하고,

마지막절에서각 단계가실패할경우의대응 계획을정리한다.

### 4.1 Phase 1 — 단일 채널 개념 증명 (Proof of Concept)

### 4.1.1 목적

LED 한 쌍(발광용1 개, 검출용1 개)만으로방전 시간 측정이재현 가능하며, 시료 간 차이를

반영하는지확인한다. 아울러Overflow Counter 와 Timeout 처리가정상 동작하는지검증한다.

### 4.1.2 재료

- 투명(무착색) LED 2개 —발광용1 개, 검출용1 개

- ATmega328P 기반 개발 보드 1 대 (Arduino Uno 보드 사용 가능, 단 개발 환경은

Microchip Studio)

- ISP 프로그래머(USBasp 등) 또는 avrdude 연동 설정
- 전류 제한 저항 1 개 (발광 LED 용, 값은 LED 사양에따라 결정)
- 브레드보드, 점퍼선
- 불투명차광 챔버 (간이 상자 또는 검은색종이로제작; 외부광차단용)
- 시료: 증류수, 식용색소를소량 첨가한착색수, 시판 무지방우유를물에 희석한탁도 시료

### 4.1.3 절차

1. 툴체인을 먼저 검증한다. Microchip Studio 와 프로그래머로레지스터 직접 제어 방식의

LED 점멸 프로그램을작성하여업로드에성공하는지확인한다.

2. 발광 LED 와 검출 LED 를 차광 챔버 내에서 시료 용기를 사이에 두고 서로 마주보도록

고정한다.

3. 검출 LED 의 캐소드를PD7 에, 애노드를GND 에 연결한다(3.2절 참조).
4. 검출 핀을 출력 모드 HIGH 로 짧게 구동하여 역방향 충전한 뒤, 입력 모드로 전환하고

Timer1 으로 방전 시간을측정한다.

5. 시료 없이(빈 챔버, 암실 상태) 암전류 기준 방전 시간을 10회 이상 반복 측정하여 평균 및

표준편차를기록한다. 이 단계에서Overflow Counter 의 동작을확인한다.

6. 증류수를채운 상태에서동일하게10회 이상 반복 측정한다.
7. 착색수시료로교체하여동일 측정을반복한다.
8. 희석 우유(탁도) 시료로교체하여동일 측정을반복한다.
9. 광 경로를완전히차단한상태에서측정을시도하여Timeout 이 정상반환되는지확인한다.
10. 각 시료조건간 평균방전시간의차이가반복측정의표준편차보다유의하게큰지비교한다.

### 4.1.4 성공 기준

다음 세 조건을모두 만족하면Phase 1을 통과한것으로판단한다.

- 동일 시료에 대한 반복 측정값의변동계수(CV)가 실용적으로허용 가능한 수준일 것 (예비

목표: 10% 이내).

- 최소 2 종 이상의 시료가 서로 구분될 것. 즉 시료군 간 평균 방전 시간의 차이가 반복 측정

표준편차보다유의하게클 것.

- Overflow Counter 와 Timeout 처리가 정상 동작할 것. 암전류 조건에서 오버플로우를

넘어선누적 계수가올바르게산출되고, 차단 조건에서Timeout 이 반환될것.

### 4.2 Phase 2 — RGB 다파장 확장

### 4.2.1 목적

파장을추가할수록실제로판별에유의미한정보가증가하는지검증하고, 최종 채널 구성을

실험적으로결정한다.

### 4.2.2 재료

Phase 1 재료에더하여, 적색·녹색·청색 발광 LED 각 1 개 이상(개체차보정 실험을위해 파장별

5 개 이상 확보 권장) 및 전류 제한 저항 3 개를 추가한다.

### 4.2.3 절차

1. 각 파장의 LED 를 PB0, PB1, PB2 에 연결하고, Red → Green → Blue 순으로 하나씩

점등하는스캔 루틴을구현한다. 한 번에 하나의LED 만 점등한다.

2. 각 파장 점등 상태에서검출 LED 의 충전–방전 측정을수행하여다차원벡터 [R, G, B] 를

구성한다.

3. Phase 1 과 동일한 시료 세트(증류수, 착색수, 탁도수)에 대해 각 파장별 방전 시간을

측정한다.

4. 채널을 R → RG → RGB 순으로 하나씩 늘려가며, 새로 추가된채널이 기존 채널 대비 시료

간 구분에추가 정보를제공하는지(채널 간 상관이낮고 판별력이있는지) 비교한다.

5. 정보 기여도가낮은 파장은최종 구성에서제외하거나낮은 우선순위로둔다.

### 4.2.4 성공 기준

최소 2 개 이상의파장 채널에서서로 다른 시료군에대해 구분 가능한다차원패턴이관찰되고,

채널 추가에따른 시료군분리도의개선이정량적으로확인될것.

### 4.3 Phase 3 — 보정 파이프라인 구현 및 강건성 확보

### 4.3.1 목적

암전류, LED 개체차, 환경광, 온도 등 실사용환경에서발생하는오차 요인에대한 보정 로직을

구현하고검증한다.

### 4.3.2 절차

1. 동일사양의LED 여러개를대상으로기준시료에대한반응값편차를측정하여개체간 보정

계수를산출한다.

2. 조명 조건(실내등 on/off, 자연광 등)을 달리하여 환경광이 측정값에 미치는 영향을

정량화하고, 발광 on/off 차분 방식의보정 효과를검증한다.

3. 가능한경우 온도를달리하며(예: 상온 대비 냉장 시료) 측정값의변화를기록하여온도 보정

필요성을평가한다. 내부 밴드갭 기준 전압은 논리 문턱값에비해 온도 안정성이높으므로,

이 구성이온도 민감도를얼마나완화하는지도함께 확인한다.

4. 3.8.1 절의 후보 보정식을 동일 데이터에 적용하고 재현성을 비교하여 최종 보정식을

확정한다.

5. 보정 전/후 측정값의 재현성(반복 측정 표준편차)을 비교하여 보정 파이프라인의 효과를

정량적으로보고한다.

### 4.4 Phase 4 — 온칩 분류 구현 및 시스템 통합

### 4.4.1 목적

전체 파이프라인(발광 → 검출 → 보정 → 정규화→ 분류 → 결과 출력)을 단일 MCU 상에서

실시간으로수행하는최종 시스템을완성하고성능을평가한다.

### 4.4.2 절차

1. Phase 1~3 에서 확보한 각 시료군의 보정된 광학 지문을 기준 중심점(centroid)으로

산출하여MCU 의 EEPROM 에 저장한다.

2. 신규 시료를측정하고, MCU 내부에서실시간으로보정 → 정규화→ 최근접중심점분류를

수행하여결과를출력한다.

3. 학습에사용되지않은 별도의검증 시료 세트로분류 정확도를평가하고혼동표(confusion

matrix)를 작성한다.

4. 프로그램 메모리 사용량(Flash) 및 데이터 메모리 사용량(SRAM/EEPROM)을 측정하여

기록하고화면을캡처한다.

5. 전체 측정·분류 1 회 사이클에 소요되는 처리 시간을 측정한다. 측정 구간의 시작과 끝에서

여유 GPIO 를 토글하고오실로스코프로펄스 폭을 읽는 방식을사용한다.

6. 측정 시작 버튼과LCD/OLED 출력을연결하여1.4 절의 데모 시나리오를완성한다.

### 4.4.3 평가 지표

- 분류 정확도(검증 시료 세트 기준) 및 혼동표
- 채널별재현성(반복 측정 CV)
- 프로그램메모리(Flash) 및 데이터메모리(SRAM/EEPROM) 사용량
- 1회 측정·분류 사이클처리 시간
- 총 부품 비용(BOM) 및 기존 포토다이오드기반 구성 대비 절감률
- Timeout 및 이상값발생 빈도

### 4.5 Phase 별 실패 대응 계획

각 단계에서예상되는실패 양상과대응 방안을사전에정리한다.

증상 | 추정 원인 | 대응
방전 시간이광량에 무관하게거의 0 | 검출 LED 극성
| 오배선(순방향) | 캐소드–GPIO, 애노드–GND 결선 재확인
| | (3.2절)
측정값이매번 크게 변동 (CV 과다) | 외부광유입, 광학 경로
| 흔들림 | 차광 챔버 밀폐 강화, LED·큐벳 고정 구조
| | 개선, 반복 횟수 증대
모든 시료에서방전 시간이 거의 동일 | 신호가잡음에묻힘, 광량
| 부족 | 발광–검출 LED 간 거리 축소, 전류 제한
| | 저항 값 하향, 고휘도LED 로 교체
암전류측정이지나치게 오래 걸림 | 누설 전류가광전류보다
| 작음 | DIDR1 로 디지털입력 버퍼 차단, Timeout
| | 값 상향 조정
RGB 3채널로시료군분리 불가 | 가시광대역만으로판별
| 정보 부족 | 근적외선(IR) 채널 추가 검토, 시료 농도
| | 범위 재설정

증상 | 추정 원인 | 대응
실내등on/off 에 따라 결과가바뀜 | 환경광보정 미흡 | 발광 ON/OFF 차분 보정 적용, 측정 창 단축
세션마다기준값이이동 | 큐벳 위치·주입량편차,
| 온도 드리프트

6.6 절 데이터관리 규칙 적용, 세션마다

기준 시료 재측정

## 5 필요 장비 및 구매 목록

### 5.1 예상 BOM (부품 가격표)

아래는최종 시스템1 대를 구성하는데 필요한부품 목록이다. 단가는국내 유통가기준

예상치이며, 실제 구매 후 확정 금액으로 갱신한다.

품목 | 사양 | 수량 | 예상 단가 | 소계 | 비고
ATmega328P | DIP 또는 개발 보드 | 1 | 5,000 | 5,000 | IC 단품 기준
발광 LED | 적·녹·청 각 1 | 3 | 200 | 600 | 투명 렌즈 제품
검출 LED | 투명(무착색) | 1 | 200 | 200 | PD7 연결
전류 제한 저항 | 220 Ω~1 kΩ | 3 | 50 | 150 | 발광 LED 용
택트 스위치 | 측정 시작 버튼 | 1 | 200 | 200 | 내부 풀업 사용
표시 장치 | I²C OLED 0.96" | 1 | 4,000 | 4,000 | 최종 시연용
샘플 큐벳 | 소형 투명 용기 | 5 | 500 | 2,500 | 세척 후 반복 사용
차광 챔버 재료 | 검정 아크릴/우드락 | 1식 | 3,000 | 3,000 | 3D 프린팅대체 가능
브레드보드·점퍼선 830핀 + M/M, M/F | 1식 | 5,000 | 5,000 | 시제품단계
ISP 프로그래머 | USBasp 등 | 1 | 5,000 | 5,000 | Microchip Studio 연동
합계 | | | | 약 25,650 원 | 실측 후 갱신

측정에 필요한 최소 구성(MCU + LED 4개 + 저항 3 개)의 부품비는 약 5,950 원이며, 나머지는

사용자인터페이스와실험 지그에해당한다. 경제성비교에서는이 최소 구성을기준으로한다.

멀티미터와오실로스코프는실험실·학교 보유 장비를활용하므로구매 목록에서제외한다.

오실로스코프는방전 파형 관찰과처리 시간 측정에사용하나필수 구매 항목은아니다.

### 5.2 기존 포토다이오드 방식과의 경제성 비교

동일한기능(다파장액체 광학 측정)을 전통적인방식으로구현할경우와본 제안 방식의부품

구성을비교한다.

구분 | 기존 포토다이오드 방식 | 제안 방식 (PEDD)
광원 | RGB LED 3개 | RGB LED 3개
검출 소자 | 포토다이오드1 개 | LED 1 개
증폭 회로 | TIA 용 OP-AMP 1 개 | 없음
수동 소자 | 피드백저항·커패시터등 4~6개 | 없음
ADC | MCU 내장 ADC 또는 외장 ADC | 불필요 (타이머 계수)
MCU | 동급 MCU 1 개 | ATmega328P 1개
추가 부품 수 | 약 6~8개 | 0 개
예상 추가 비용 | 약 3,000~6,000원 | 0 원

절감률은다음 식으로산출한다.

절감률(%) = (기존 방식 부품비 − 제안 방식 부품비) / 기존 방식 부품비 × 100

아날로그프론트엔드를제거함으로써부품 수와 비용뿐아니라회로 면적, 아날로그설계 난이도,

노이즈대책 부담도함께 감소한다. 선행 연구는포토다이오드기반 대비 약 18%의 비용 절감을

보고한바 있으며, 본 연구는최종 제작 후 실제 구매가를기준으로절감률을산출하여비교한다.

### 5.3 구매 전략

정식 부품 발주 전, Phase 1 개념 증명은보유 중인 LED 와 개발 보드만으로우선 수행한다. 개념

증명이성공적으로확인된이후에RGB 확장용LED 와 표시 장치를구매하여불필요한지출과

시간 낭비를방지한다. 다만 ISP 프로그래머는툴체인검증에필요하므로착수 시점에함께

확보한다.

## 6 실험 수행 방법 (장비 사용 절차)

### 6.1 GPIO 상태 시퀀스 및 회로 구성

검출 LED 는 캐소드를 PD7(AIN1) 에, 애노드를 GND 에 연결한다. 이 결선에서PD7 을 HIGH 로

구동하면캐소드전위가애노드보다높아져역방향바이어스가성립하고접합 정전용량이

충전된다. 반대 결선(애노드를GPIO 에 연결)은 순방향바이어스가되어 LED 가 점등될뿐 전하가

축적되지않으므로측정이성립하지않는다.

1회 측정 사이클의GPIO 및 주변장치상태 변화는다음과같다.

단계 | 발광 LED | PD7 (검출) | Timer1 / Comparator | 확인 사항
① 대기 | 전체 소등 | 입력, 풀업 해제 | 정지 | 이전 측정 종료 상태
② 파장 선택 | 해당 1 개 점등 | 입력 유지 | 정지 | 한 번에 하나만점등
③ 충전 | 점등 유지 | 출력 HIGH | 정지 | 수 μs 면 충분 (접합 용량이작음)
④ 방전 개시 | 점등 유지 | 입력 전환, 풀업 해제 | TCNT1=0, 오버플로우카운터=0,
| | | ICF1·TOV1 클리어후 기동 | 플래그클리어누락 시 즉시 오탐

⑤ 임계

통과

| 점등 유지 | 전압 강하 진행 | 1.1 V 하회 시 ACO 0→1, ICR1 에 캡처 | 하드웨어기록이므로ISR 지연 무관
⑥ 종료 | 소등 | 입력 유지 | 정지, 누적 계수 산출 | Timeout 초과 시 TIMEOUT 반환

위 ③~⑤ 과정을하나의측정 사이클로정의하고, 각 조건마다최소 10회 이상 반복하여평균과

표준편차를계산한다.

### 6.2 Analog Comparator · Timer1 설정

방전 임계점판정에는ATmega328P의 Analog Comparator 를 사용하며, 그 출력을Timer1

Input Capture 의 트리거로연결한다. 초기화시 설정할레지스터비트는다음과같다.

레지스터 | 비트 설정 | 목적
ACSR | ACBG = 1 | 내부 1.1 V 밴드갭을비교기양극 입력으로선택
ACSR | ACIC = 1 | 비교기 출력을 Timer1 Input Capture 에 연결. 이 비트가0 이면 캡처가발생하지않는다
ACSR | ACD = 0 | 비교기활성 상태유지 (리셋기본값)

레지스터 | 비트 설정 | 목적
ADCSRB | ACME = 0 | AIN1(PD7)을 음극입력으로유지. 리셋 기본값이므로별도로 설정하지않는다
DIDR1 | AIN1D = 1 | PD7 의 디지털입력 버퍼를차단하여누설 전류로인한 측정 오차를 억제
TCCR1B | ICES1 = 1 | 상승 에지 캡처. 방전 전압이1.1 V 아래로내려가면ACO 가 0→1로 전이하므로상승 에지가맞다
TCCR1B | CS11 = 1 | 프리스케일러/8 (16 MHz 기준 500 ns 분해능)
TIMSK1 | ICIE1 = 1, TOIE1 = 1 | 입력 캡처 및 오버플로우인터럽트활성화

캡처 에지의방향은데이터시트상위와 같이 상승 에지가되어야하나, 실제 구현 시

오실로스코프로방전 파형과캡처 시점을함께 관찰하여확정한다. 밴드갭기준 전압은활성화후

안정화시간이필요하므로, 매 측정마다켜고 끄지 않고 초기화시 한 번 활성화하여유지한다.

### 6.3 다파장 스캔 절차

1. 각 발광 LED 에 대해 순차적으로 수행한다. (a) 해당 LED 를 순방향으로 점등하고, (b)

6.1절의 충전–방전 측정을수행한다.

2. 모든 파장에대한 측정이끝나면하나의다차원벡터 [t_R, t_G, t_B] 로 저장한다.
3. 발광LED 를모두끈상태에서동일한검출절차를수행하여환경광성분을별도로측정하고,

차분 보정에사용한다.

4. 각 파장 측정 사이에는이전 파장의잔광 영향을배제하기위한 짧은 대기 구간을둔다.

### 6.4 시료 측정 프로토콜

1. 매 측정 전 챔버와큐벳을증류수로세척하고건조시켜이전 시료의잔류 영향을제거한다.
2. 기준 시료(증류수)를 측정하여해당 세션의기준값을재확인한다(세션 간 드리프트점검).
3. 실험 대상 시료를채우고6.3 절의 다파장스캔을수행한다.
4. 동일 시료에 대해 30회 반복 측정한다. 이 중 20회는 기준 중심점 산출에, 10회는 검증에

사용한다(6.6절 참조).

5. 모든 원시 측정값을 UART 시리얼 통신을 통해 PC 로 로깅하여 별도로 통계 분석 및

기준점(centroid) 산출에사용한다.

### 6.5 보정 계수 산출 절차

1. 암전류 보정값: 발광 LED 를 모두 끄고 챔버를 완전히차광한 상태에서채널별방전 시간을

측정하여오프셋으로저장한다.

2. 개체차보정값: 동일조건(증류수)에서여러LED 개체의측정값을비교하여채널별스케일링

계수를산출한다.

3. 두 보정값을적용한최종 정규화값 = (측정값− 암전류오프셋) × 스케일링계수.
4. 3.8.1절의 절차에따라 후보 보정식을비교하고재현성이가장 높은 방식을최종 채택한다.

### 6.6 데이터 관리 규칙

측정 편차를줄이고결과의신뢰성을확보하기위해 다음 규칙을적용한다.

- 큐벳 방향과 주입 높이를 통일한다. 큐벳에기준표시를하여항상동일한방향으로삽입하고,

시료주입량을일정하게유지한다. 용기위치와액면높이는광 경로길이를바꾸어직접적인

측정 오차가된다.

- 시료 측정 순서를 무작위화한다. 항상같은순서로측정하면시간에따른드리프트(온도변화,

LED 발열)가 시료 간 차이로위장될수 있다. 세션마다순서를바꾸어측정한다.

- 세션 시작과 종료 시 기준 시료(증류수)를 측정한다. 두 값의 차이로 해당 세션의 드리프트

크기를확인하고, 허용 범위를넘으면해당 세션 데이터를재측정한다.

- 원시 로그에 다음 항목을 모두 기록한다. 시료ID, 파장별방전시간(R/G/B), 오버플로우횟수,

Timeout 발생 여부, 측정 순번, 타임스탬프, 주변 조명 조건.

- 보정 후 값이 아닌 원시 값을 저장한다. 보정식이이후에변경되더라도원시데이터가있으면

재계산이가능하다.

### 6.7 분류기 검증 절차

1. 각 시료군에대해 확보한30회 측정값중 20회의 평균 벡터를해당 그룹의기준 중심점으로

설정한다.

2. 나머지10회는기준점산출에사용하지않고검증전용으로분리한다. 검증데이터가기준점

생성에섞이지않도록데이터파일 단계에서분리한다.

3. 검증측정값과각 기준중심점간 제곱거리를계산하여가장가까운그룹으로분류하고, 실제

라벨과비교하여정확도와혼동표를산출한다.

4. 위 분류 로직을 MCU 펌웨어 상에 이식하여, PC 상에서 계산한 결과와 MCU 내부 계산

결과가 일치하는지 교차 검증한다. 고정소수점 연산에 따른 오차가 분류 결과를 바꾸지

않는지확인하는것이 목적이다.

### 6.8 프로그램 전체 흐름

[그림 2] 프로그램 흐름도 — 삽입 예정. 아래 순서를플로우차트로작성하여본 위치에삽입한다.

1. 초기화 —클럭, GPIO 방향, Analog Comparator, Timer1, UART 설정 (6.2절 레지스터

표)

2. EEPROM 에서 기준 중심점로드
3. 측정 시작 버튼 입력 대기
4. 암조건측정 —발광 LED 전체 소등 상태에서환경광성분 측정
5. 파장 루프 시작 —Red → Green → Blue
6. 해당 발광 LED 점등 → 검출 LED 충전 → High-Z 전환 → Timer1 기동
7. 캡처 인터럽트대기 (오버플로우누적, Timeout 감시)
8. 방전 시간 산출 및 저장 → 발광 LED 소등
9. 파장 루프 종료 —벡터 [R, G, B] 완성
10. 보정 적용 —암전류오프셋차감, 개체차스케일링, 환경광차분
11. 최근접중심점분류 —각 중심점과의제곱 거리 비교
12. 결과 출력 —UART 전송 및 LCD/OLED 표시
13. 대기 상태로복귀

## 7 예상 일정 및 단계별 완료 판단

각 단계는날짜가아니라산출물과통과 조건으로완료를판단한다. 다만 예선 마감과본선 일정이

고정되어있으므로목표 시점을함께 명시한다.

단계 | 목표 시점 | 산출물 | 통과 조건
툴체인검증 | 착수 즉시 | Microchip Studio 빌드·업로드 성공 로그 | 레지스터직접 제어로LED 점멸 동작
Phase 1 | 예선 마감 이전 | 단일 채널 방전 시간 데이터,
| | 오버플로우·Timeout 동작 로그

CV 10% 이내, 시료 2 종 이상 구분, 예외

처리 정상 동작

Phase 2 | 예선 마감 이전 | RGB 3채널 측정 데이터, 채널별
| | 판별력비교표

채널 추가에따른시료군분리도개선 확인

예선 제출 | 2026-09-18 | PPT 보고서, 회로도PDF, 소스코드,
| | 동작 동영상

4 종 제출물완비

Phase 3 | 예선 결과 발표(10/2)
| 이후

보정 전후 재현성비교 데이터, 최종

보정식

보정 후 반복 측정표준편차감소 확인

Phase 4 | 본선
| 튜토리얼(10/8~10/29)
| 이전

온칩 분류 펌웨어, 혼동표,

메모리·처리시간측정치

PC 계산 결과와MCU 계산 결과 일치

시스템통합 | 본선(11/18~11/20)
| 이전

버튼·LCD 포함최종 시스템, 발표

자료

1.4절 데모 시나리오전 과정 무인 동작

Phase 1과 Phase 2가 예선 마감까지모두 완료되지못할 경우, Phase 1 결과만으로예선

보고서를작성하고Phase 2 이후를향후 계획으로서술한다. 경진대회는동작 결과와함께 문제

해결 과정을평가하므로, 미완료부분을명시하는것이 누락하는것보다유리하다.

## 8 한계점 및 향후 연구

### 8.1 측정 원리에 기인한 한계

- 방전시간측정방식의특성상매우낮은광량또는매우높은광량영역에서선형성이저하될

수 있으며, 이는 Phase 1~2 실험을통해 정량적으로확인되어야한다.

- 암전류 조건에서는 방전 시간이 수 초 이상으로 길어져 측정 처리량이 제한된다. Timer

Overflow 누적과Timeout 처리로대응하나, 측정 시간 자체를줄이지는못한다.

- 다파장 채널 수 증가는 측정 사이클 시간을 증가시키므로, 실시간성이 중요한 응용에서는

채널 수와 처리 속도 간 트레이드오프를명시적으로보고해야한다.

### 8.2 하드웨어에 기인한 오차 요인

- LED 개체차: 동일사양LED 간 접합정전용량과광 감도편차가존재하여, 소자를교체하면

재보정이필요하다.

- 내부 밴드갭 기준 전압 편차: 1.1 V 기준값은 개체 간 편차를 가지므로 절대적인 광량

환산에는 적합하지 않다. 본 연구는 동일 장치 내 상대 비교만을 사용하므로 영향이

제한적이나, 장치 간 결과 이식에는제약이된다.

- GPIO 누설 전류: 핀 누설이 광전류와 경쟁하여 특히 저광량 영역의 측정을 왜곡한다.

DIDR1 로 디지털입력 버퍼를차단하여완화하나완전히제거되지는않는다.

- 주변광: 차광챔버와발광ON/OFF 차분으로억제하나, 강한외부광환경에서는잔여영향이

남을 수 있다.

- 큐벳 위치·오염·기포: 용기의삽입위치, 표면오염, 기포혼입은광경로를변화시켜직접적인

오차가된다. 6.6절의 데이터관리 규칙으로관리하나완전한통제는어렵다.

- 온도: 온도보정은Phase 3에서시간이허락하는범위 내에서예비적으로만다루며, 정밀한

온도 보상 모델링은향후 연구로남긴다.

### 8.3 적용 범위의 한계

- 초기 실험은 통제된 대조 시료(색소수, 희석 우유 등)에 한정하며, 실제 오염 물질에 대한

일반화가능성은후속 연구 과제로남긴다.

- RGB 3채널은가시광대역만을다루므로, 가시광에서흡광 특성이유사한물질은 구분되지

않는다. 판별 대상의확장에는채널 수 증설이필요하다.

- 최근접 중심점 분류기는 각 시료군이 구형으로 분포한다고 가정하므로, 분포가 크게

비대칭인경우 판별 성능이저하될수 있다.

### 8.4 향후 연구

- 발광·검출 겸용 구조: 모든 LED 가 발광과 검출을 겸하는 구성으로 확장하면 검출 전용

소자를제거할수있다. LED당2핀이필요하고모드전환로직이복잡해지므로, 핀수최적화

기법과함께 검토한다.

- GPIO 핀 수 최적화: 공통선구성이나채널다중화를통해N 채널시스템의핀 사용량을N+1

수준으로줄이는방안을검토한다.

- 근적외선(IR) 채널 추가: 가시광만으로판별이 어려운 시료군에 대해 IR 대역을 추가하여

판별력을확장한다.

- 정밀 온도 보상 모델링: 온도 센서를추가하고온도–방전 시간 관계를모델링하여보정한다.
- 분류기 확장: 소형 결정트리또는 경량 선형 분류기로확장하여비대칭분포에대응한다.

## 참고문헌

1. Mims, F. M. (1992). Sun photometer with light -emitting diodes as spectrally

selective detectors. Applied Optics, 31(33), 6965–6967.

2. Fay, C., Lau, K. T., Beirne, S., Conaire, C. Ó., McGuinness, K., Corcoran, B., … &

Diamond, D. (2010). Wireless aquatic navigator for detection and analysis

(WANDA). Sensors and Actuators B: Chemical, 150(1), 425–435.

3. PEDD 기반 탁도 측정 시스템의ISO 7027 표준 비교 검증 연구 (Dublin City University,

Diarmuid Diamond 연구 그룹). PubMed Central: PMC8749822.

4. PEDD 시스템에서펌웨어 타이밍 설계가 측정 정확도에미치는 영향에 관한 연구 (Dublin

City University 연구 그룹). PubMed Central: PMC8879031.

5. Microchip Technology. ATmega48A/PA/88A/PA/168A/PA/328/P Data Sheet —

Analog Comparator, 16-bit Timer/Counter1 with Input Capture.

6. 서울대학교 차세대반도체 혁신융합대학 사업단. (2026). 2026 COSS 차세대반도체

Microcontroller(MCU) 응용경진대회운영 지침.
