jms1005/coss-led-pedd-analyzer/(commit log)

2026-09-03 chore: 기존 작업 스냅샷
    계획서, 회로도, phase1~2 펌웨어, Studio 프로젝트 파일까지의 현재 상태.
    Claude-Session: https://claude.ai/code/session_01Q8WVErNZ81L558oXDgDfCD
2026-09-03 chore: gitignore 패턴 수정 — 빌드 산출물 추적 해제
    */Debug/ 는 한 단계 아래만 매칭해 firmware/01_blink/Debug/ 가 잡히지 않았다.
    Debug/ 로 바꿔 모든 깊이에서 제외한다.
    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
2026-09-03 chore: phase4 프로젝트 껍데기와 호스트 테스트 러너 추가
    - 04_phase4 프로젝트를 phase1.cproj 를 본떠 생성하고 솔루션에 등록
    - componentinfo.xml 을 함께 둔다. 없으면 Studio 가 프로젝트를 못 연다
    - classify 를 PC 에서 돌리기 위한 tools/run_host_tests.sh 추가
    빌드 검증: 4 succeeded, 0 failed (phase4 스텁 278 B / 0.8%)
    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
    [main.c]
2026-09-03 feat: 광학 지문 계산과 최근접 중심점 분류 모듈 추가
    방전 시간 -> 컨덕턴스 -> 암전류 보정 -> 정규화 -> 제곱거리 판정까지
    전 구간 32비트 정수로 처리한다. float 를 쓰지 않아 소프트웨어 부동소수점
    라이브러리가 링크되지 않는다.
    정규화는 곱셈 전에 세 채널을 함께 우측 시프트해 오버플로우를 막는다.
    나눗셈을 먼저 하는 방식은 sum 이 작을 때 정규화가 깨져 채택하지 않았다.
    호스트 단위 테스트 24개 단언 전부 통과. 경계값(t=1, t=3997696),
    DARK 타임아웃, 0 나누기 방어를 포함한다.
    Cl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
2026-09-03 feat: EEPROM 중심점 저장 모듈 추가
    EECR/EEDR/EEARH/EEARL 레지스터를 직접 제어한다. EEMPE 를 세운 뒤
    4클럭 안에 EEPE 를 세워야 하므로 그 구간만 원자 구간으로 감쌌다.
    매직/버전/클래스 수/체크섬 네 가지를 모두 검사해야 유효로 본다.
    공장 출하 상태(전부 0xFF)는 자연스럽게 무효로 걸러진다.
    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
2026-09-03 feat: TWI 마스터 드라이버 추가
    TWBR=12 로 400kHz. SSD1306 화면 갱신 속도에 직접 영향을 준다.
    모든 대기 루프에 상한을 두어 슬레이브가 없어도 유한 시간에 반환한다.
    OLED 배선이 잘못돼도 측정과 UART 로깅은 계속되어야 하기 때문이다.
    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
2026-09-03 feat: SSD1306 OLED 드라이버와 6x8 폰트 추가
    프레임버퍼를 두지 않는다. 128x64/8 = 1024바이트로 SRAM 2KB 의 절반이라
    쓸 수 없다. 페이지 주소 모드로 화면에 직접 쓴다.
    폰트는 tools/gen_font.py 가 생성한다. 384바이트를 손으로 입력하면 오타가
    나기 때문이다. 화면 문구에 쓰이는 문자가 빠지면 생성이 중단된다.
    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
2026-09-03 feat: 택트 스위치 디바운스 모듈 추가
    20ms 폴링. 짧게는 뗀 순간, 길게는 2초를 채우는 순간 발동한다.
    길게가 떼기 전에 발동해야 사용자가 화면 안내를 보고 손을 뗄 시점을 안다.
    INT0 인터럽트를 쓰지 않는다. Timer1 입력 캡처 타이밍에 지터를 줄 수 있다.
    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
2026-09-03 feat: Phase 4 상태머신 구현
    버튼 -> DARK/R/G/B 스캔 -> 보정 -> 정규화 -> 최근접 중심점 -> OLED + UART
    전 과정을 MCU 안에서 수행한다. 학습 모드로 3종 중심점을 EEPROM 에 저장한다.
    화면 문구를 전부 PROGMEM 으로 옮겼다. AVR 은 일반 문자열 리터럴을 부팅 시
    SRAM 으로 복사하는데, 처음 구현에서 이것만으로 .data 가 422바이트를 차지해
    SRAM 23.6% 를 썼다. ssd1306_puts_p() 를 추가해 Flash 에서 직접 읽는다.
    메모리: Flash 6634 B (20.2%), SRAM 90 B (4.4%)
    - 부동소수점 라이브러리 미링크 확인 (정수 설계가 의도대로 동작)
    - SRAM 483 B -> 90 B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
2026-09-03 docs: Phase 4 사용법과 하드웨어 브링업 체크리스트 추가
    - README 에 04_phase4 절, 새 모듈 6개, 갱신된 메모리 표 반영
    - avrdude 가 winget 으로 이미 설치되었음을 명시
    - 부품 도착 후 단계별 연결 순서를 별도 체크리스트로 분리
    브링업을 단계로 나눈 이유는 한 번에 다 연결하면 어느 모듈이 문제인지
    가릴 수 없기 때문이다. 지금까지 검증된 것은 "컴파일이 되고 계산 로직이
    맞다"까지이고, 드라이버 4종은 실물에서만 확인된다.
    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
2026-09-03 docs: 저장소 최상위 README 추가
    GitHub 첫 화면에서 프로젝트 개요·원리·구성·빌드 방법이 보이도록 정리했다.
    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
2026-09-03 fix: CSV 헤더를 부팅 시 한 번만 출력
    log_uart() 가 측정마다 헤더를 반복 출력해, 터미널로 받은 로그 파일에
    헤더가 데이터 사이에 섞였다. 분석 스크립트가 이 줄을 데이터로 읽는다.
    헤더를 log_uart_header() 로 분리해 초기화 직후 한 번만 내보낸다.
    주석 행은 '#' 으로 시작시켜 tools/analyze.py 의 무시 규칙과 맞췄다.
    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
    [main.c]
2026-09-03 fix: 회로도와 펌웨어의 핀 사용을 일치시키고 제출용 PDF 생성
    회로도에 PB5 가 빠져 있었다. 펌웨어는 이 핀을 사이클 시간 측정용 타이밍
    출력으로 쓰는데 도면에 없어, 핀 수가 채점 항목인 상황에서 심사위원이
    소스와 도면을 대조하면 어긋난다. TP1 테스트 포인트로 추가했다.
    PD0(RXD)은 헤더 배선만 있고 펌웨어가 쓰지 않는다는 점을 주석 10 으로 명시.
    인쇄 래퍼는 width:100% 때문에 세로가 A3 인쇄 영역을 넘어 2페이지로
    잘리고 있었다. 높이를 285mm 로 고정해 1페이지로 맞췄다.
    tools/make_pdf.sh 로 SVG 재생성부터 PDF 출력까지 한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
    [make_schematic.py]
2026-09-03 docs: 예선 보고서 PPT 초안 생성기 추가
    제출물/예선_PPT_골격.md 의 21장 구성을 pptx 로 만든다. 운영설명 「4-가」의
    7개 필수 항목과 1:1 대응하며, 각 슬라이드 우상단에 해당 항목 번호를 적어
    심사위원이 항목을 찾지 못하는 상황을 막는다.
    실험 결과가 필요한 슬라이드 11·12 와 실제 구매가가 필요한 21 은 붉은
    안내 상자로 비워두었다. 측정이 끝나면 그 상자만 교체하면 된다.
    한글은 <a:latin> 이 아니라 <a:ea> 를 따르므로 두 글꼴을 함께 지정한다.
    지정하지 않으면 PowerPoint 가 기본 글꼴로 대체한다.
    도면은 SVG 를 넣을 수 없어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
2026-09-03 docs: 계획서에 도면 3장 삽입, 측정 프로토콜·촬영 시나리오 추가
    계획서_수정사항.md ⑤항 처리. 3.1절 블록도, 6.8절 흐름도의 "삽입 예정"
    자리표시를 그림으로 교체하고, 6.1절에는 회로도를 새로 넣었다. 6.1절은
    검출 LED 극성을 글로만 설명하고 있었는데, 이 극성이 설계의 핵심 실패
    지점이라 그림이 필요했다.
    Word 는 SVG 삽입이 판본에 따라 불안정해 PNG 를 쓴다.
    삽입 전 원본은 backup/ 에 타임스탬프로 남긴다.
    측정 프로토콜은 인쇄해서 쓰는 체크시트다. 세척 누락이나 순서 착오는
    데이터를 통째로 못 쓰게 만드는데 측정 중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
    [insert_figures.py]
2026-09-03 docs: PPT 제작 방식 2단계 계획 기록
    실험 결과가 나오기 전에 HTML 기반으로 디자인하면 내용이 바뀔 때마다
    재작업이 생긴다. 내용 확정(현재 pptx) -> 디자인 전환(HTML 렌더) 순서로
    진행하기로 결정했다.
    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
2026-09-03 docs: 차광 챔버 제작 가이드 추가
    부품 도착 전 유일한 제작 항목이라 별도 문서로 분리했다.
    챔버의 역할 5가지(외부광 차단, CV 억제, 암전류 보정 전제,
    광학 정렬 지그, 미광 억제)와 제작 순서, 누광 검사 2단계를 정리했다.
    측정_프로토콜.md 0절의 "차광 챔버 완성" 항목이 이 문서를 가리킨다.
    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
2026-09-03 docs: 큐벳 대용 용기 고르는 기준 추가
    기존 "소스통·미니 시약병" 기재는 광학 조건을 따지기 전에 적은 것이라
    바로잡았다. 소스통은 대부분 유백색 반투명 PP 원통이라 산란체로 작용하고
    실린더 렌즈 효과까지 생긴다.
    완전 투명·평평한 측벽·내부 폭 10~20mm·세트 구매를 조건으로 정하고
    매장 즉석 검사법과 대안(일회용 PS 큐벳)을 함께 적었다.
    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
2026-09-04 docs: 일회용 PS 큐벳(KA.CV-135) 확정 및 챔버 치수 계산
    큐벳을 다이소 대용 용기에서 표준 일회용 PS 큐벳으로 확정했다.
    광로 10mm, 외형 12.5x12.5x45mm, 투과 파장 340~900nm 로 3채널(470/525/630)과
    백업 850nm IR 을 모두 커버한다.
    - 차광챔버: 확정 규격 기준으로 내부 치수(40x33x65mm), 광축 높이 20mm,
    우드락 재단 목록, 주입량 2.5mL 고정 근거를 계산해 기재
    - 구매목록: 다이소 용기 선정 기준을 확정 스펙 절로 교체, 배송 도착일과
    4면/2면 투명 여부만 확인 항목으로 남김. 주입량 고정용 5mL 주사기 추가
    - 측정 프로토콜: 계획서 6.4절 세척 절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
2026-09-04 docs: 큐벳 세미마이크로 구조 반영 — 광축·주입량을 실측 절차로 변경
    제품 사진에서 하단 약 40% 구간의 벽이 안쪽으로 두꺼워진 것이 확인됐다.
    내부가 10x10x45mm 라면 가득 채워 4.5mL 여야 하는데 스펙은 1.6mL 이므로,
    광로 10mm 는 유지한 채 직각 방향 폭만 좁힌 세미마이크로 구조로 보인다.
    앞 커밋에서 확정한 주입량 2.5mL 와 광축 높이 15mm 는 이 구조에서
    성립하지 않는다(1.6mL 가 최소 권장량이 아니라 최대 용량일 수 있음).
    숫자를 박아두는 대신 도착 후 실측 절차로 바꾼다.
    - 차광챔버: 광축 높이·주입량을 실측 후 결정하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
2026-09-04 docs: 세미마이크로 채널 대비 슬릿(조리개) 지침 추가
    내부 채널 폭이 약 4mm 이면 5mm 발광 LED 의 광속이 채널보다 넓어,
    채널을 비껴간 빛이 시료를 통과하지 않고 측벽을 타고 검출 LED 에 도달한다.
    1절 역할 5의 미광에 해당하며 시료 간 분리도를 떨어뜨린다.
    - 검정 도화지 3x8mm 세로 슬릿으로 대응. 별도 부품 구매 불필요
    - 광량도 함께 줄어들므로 처음부터 넣지 않고, 미광이 확인된 뒤 적용하는
    4단계 순서로 기재
    - 채널이 10x10mm 로 확인되면 불필요하다는 판정 기준도 명시
    - 측정 프로토콜 트러블슈팅에 "시료 간 차이가 유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
2026-09-04 docs: 앞·뒤벽 재단 치수 오류 수정 (50x65 -> 40x65)
    맞대기 접합에서는 한쪽 방향 벽만 바깥 치수를 차지하고 다른 쪽은 그 사이에
    끼어야 한다. 좌·우벽이 43mm 로 전체 깊이를 차지하므로 앞·뒤벽은 내부 폭인
    40mm 만 차지한다. 둘 다 50mm 로 자르면 모서리가 10mm 씩 겹쳐 상자가
    닫히지 않는다.
    Claude-Session: https://claude.ai/code/session_01AzDgaChaASGvDsAFbx6gRW
2026-09-04 feat: 차광 챔버 제작 도면 생성기 추가 (A4 6장, 1:1 재단 템플릿)
    부품 도착 전에 챔버를 만들 수 있도록, docs/차광챔버_제작.md 의 치수를
    인쇄해서 보며 작업할 수 있는 도면으로 옮겼다.
    1장 조립 그림 + 부품 10개 목록
    2~4장 1:1 실척 재단 템플릿 (바닥·뚜껑·마개 / 벽 4장 / 지그·슬릿)
    5장 조립 순서 8단계
    6장 단면도·누광 검사·완성 체크리스트
    - SVG 1 단위 = 1mm 로 그리고 인쇄 래퍼가 A4 210x297mm 로 못박아 1:1 보장.
    생성할 때마다 용지 크기와 viewBox 를 자체 점검하고, 2~4장에는 인쇄 배율
    검증용 100mm 눈금자를 넣었다
    - LED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
2026-09-04 chore: __pycache__ 를 git 에서 제외
    도면 생성기를 커밋할 때 파이썬 바이트코드 캐시가 함께 들어갔다.
    추적에서 빼고 .gitignore 에 추가한다.
    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
2026-09-04 fix: 도면 검토에서 나온 오류 4건 수정
    전체 도면을 다시 보며 치수를 교차 검산해 나온 것들이다.
    1. 광축 높이 근거가 틀렸다 (문서)
    지그는 가운데가 뚫린 프레임이라 큐벳을 떠받치지 않는다. 큐벳은 홈을
    통과해 챔버 바닥에 그대로 닿으므로 "지그 두께 5mm + 큐벳 바닥에서
    15mm" 는 성립하지 않는다. 값 20mm 는 우연히 같지만 실측 규칙이
    달라진다 — 투명 구간의 중앙을 큐벳 바닥에서 잰 값이 곧 --axis 다.
    2. 발광 LED 구멍 사이 살이 1.5mm 였다 (제작 위험)
    구멍 5mm 에 중심 간격 6.5mm 면 우드락이 찢어진다. 간격을 7mm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
    [build_drawings_lib.py, make_build_drawings.py]
2026-09-04 feat: 브레드보드 배선도 4장 추가
    회로도는 심사 제출용이라 부품 기호로 그려져 있어 실제 브레드보드와
    대응이 잘 안 된다. 어느 구멍에 무엇을 꽂는지만 그린 도면을 따로 만든다.
    1장 한눈에 보기 (연결 요약 + 핀 대응표 + LED 다리 구별법)
    2장 브레드보드 배치도 (열·행 번호까지 지정)
    3장 연결 순서 6단계
    4장 연결 확인표 26칸 + 문제 생겼을 때 볼 곳
    핀 배정은 펌웨어에서 그대로 옮겼다 (pedd.c / button.c / i2c.c).
    위쪽 반과 아래쪽 반이 서로 다른 마디라는 점을 이용해 열이 겹치지 않게
    배정했고, 버튼은 대각선 두 다리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
2026-09-05 docs: 재배선을 위해 초기화하되 브링업 실측 지식은 유지
    배선을 처음부터 다시 연결하기 위해 작업 내역을 master 시점으로 되돌렸다.
    다만 실물 보드에서 실제로 측정해 얻은 내용까지 버리면 같은 실수를 그대로
    반복하게 되므로 그 부분만 남긴다.
    - docs/실수_방지_체크리스트.md: 증상-원인 대조표, 차광 검증 기준
    - 배선도의 틀린 서술 수정
    · "거꾸로 꽂으면 전부 TIMEOUT" -> 실측은 0~1 tick 고정.
    TIMEOUT 은 미접속·단선일 때 나오므로 정반대 원인이다.
    · 검출 LED 캐소드 판별을 다리 길이에서 렌즈 안 반사컵 기준으로 변경.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
    [make_wiring_drawings.py]
2026-09-05 docs: 배선도 PDF 를 수정된 도면으로 재생성
    인쇄해서 보는 PDF 가 옛 서술을 담고 있으면 SVG 만 고친 의미가 없다.
    sh tools/make_wiring_pdf.sh 로 다시 묶었다. A4 4페이지.
    Claude-Session: https://claude.ai/code/session_018r3qiZHt6L2CGg5Xmwp7uS
2026-09-05 feat: 전기 흐름 설명 그림 3장 생성 스크립트 추가
    배선도(figures/wiring)가 "어느 구멍에 꽂는가"를 답한다면, 이 그림은
    "왜 그렇게 꽂는가"를 답한다. 처음 보는 사람에게 전기가 어디서 시작해
    어떻게 흐르는지 보여주는 것이 목적이다.
    flow1 발광 LED 회로 — USB 에서 출발해 GND 로 돌아오는 한 바퀴
    flow2 검출 LED — 충전과 방전 2단계, 1.1V 까지 떨어지는 전압 곡선
    flow3 빛과 정보의 흐름 — 발광에서 판정까지
    인쇄용이 아니라 화면에서 읽는 가로 그림이라 build_drawings_lib 의
    A4 Sheet 틀은 쓰지 않고 색과 글꼴만 공유한다.
    핀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
2026-09-05 docs: 처음 보는 사람을 위한 쉬운 설명 문서 추가
    전자공학을 모르는 사람이 저장소를 열었을 때 읽을 것이 계획서 PDF 밖에
    없었다. 원리를 초등학생 눈높이로 풀어 쓴 문서를 만든다.
    - LED 가 빛을 내기도 하고 느끼기도 한다는 점부터 설명
    - 전기가 USB 에서 출발해 GND 로 돌아오는 한 바퀴를 그림과 표로
    - 충전 후 방전 시간을 재는 원리를 물컵 비유로
    - 어려운 말 사전 11개 항목
    내용은 펌웨어와 대조해 맞췄다 (핀 번호, 학습 순서, 충전 시간, 1.1V 기준).
    액체별 시간 표는 아직 실측 전이라 예시임을 명시했고, 저항은 실험 중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
2026-09-05 feat: 전기 흐름 그림을 PNG 로도 내보내고 문서가 PNG 를 쓰게 변경
    GitHub 는 마크다운 안의 SVG 를 보안 필터를 거쳐 보여주는데, 이때 글꼴이
    보는 사람 컴퓨터의 기본값으로 바뀌어 글자 간격이 달라질 수 있다. 웹에서
    읽는 문서라 어디서 보든 같게 나오는 편이 낫다.
    - tools/make_flow_png.sh 추가. render_figures.sh 와 같은 방식으로
    Chrome 헤드리스를 써서 2배 배율 PNG 를 만든다. 장마다 크기가 달라
    viewBox 를 읽어 창 크기를 정하고, 한글 경로를 피해 임시 ASCII 경로에서
    변환한다.
    - docs/쉬운_설명.md 의 그림 3장이 PNG 를 참조하도록 변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
2026-09-05 docs: 코드에 처음 읽는 사람을 위한 설명 주석 추가
    기존 주석은 "왜 이 값인가", "여기서 막히기 쉽다" 같은 구현 메모 위주라
    이미 배경을 아는 사람에게는 충분하지만, 처음 보는 사람에게는 그 모듈이
    무엇을 하는 물건인지가 빠져 있었다. 파일 첫머리에 "처음 읽는 사람을
    위한 요약" 블록을 달고, 전문 용어가 처음 나오는 자리에 풀이를 붙였다.
    - pedd.c 물컵 비유로 측정 4단계. 하드웨어 캡처를 쓰는 이유
    - classify.c 시간->밝기->지문->이름 3단계. 왜 비율만 쓰는지, 뉴턴법 isqrt
    - button.c 디바운스가 무엇인지, 풀업이라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
2026-09-05 docs: Studio 빌드 기준으로 메모리 사용량 표 갱신
    Microchip Studio 로 Debug 구성 4개를 다시 빌드해 실측값으로 맞췄다.
    phase4 만 6,634 -> 6,672 B (20.2% -> 20.4%) 로 바뀌었고 나머지 셋과
    SRAM 값은 그대로다.
    늘어난 38바이트는 c38521d "CSV 헤더를 부팅 시 한 번만 출력" 에서
    log_uart_header() 와 PSTR 문구가 추가된 몫이다. 그 커밋이 README 표를
    같이 고치지 않아 그동안 표가 한 커밋 뒤처져 있었다. 직전 커밋에서 넣은
    주석과는 무관하다 (주석은 바이너리에 영향이 없고, 수정 전후를 같은
    명령으로 빌드해 동일함을 확인했다).
    Studio 빌드와 명령줄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
2026-09-05 docs: 검출 LED 극성 서술을 브링업 실측 기준으로 수정
    실수_방지_체크리스트.md 의 실측 기록과 firmware/README.md 가 서로
    반대되는 말을 하고 있었다. 배선하면서 실제로 여는 쪽이 README 라
    그쪽을 실측에 맞춘다.
    - 극성 반대 시 결과를 명시: `0~1 tick` 고정 (TIMEOUT 아님)
    - 과전류 위험 경고 추가. 검출 LED 만 전류 제한 저항 없이 직결이라
    뒤집힌 채로 재시도를 반복하면 소자가 상할 수 있다
    - 문제 해결표에서 정반대 증상에 같은 원인이 적혀 있던 것을 분리:
    TIMEOUT 의 원인은 극성이 아니라 미접속·단선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
2026-09-05 docs: 측정 프로토콜의 TIMEOUT 원인도 실측 기준으로 수정
    firmware/README.md 와 같은 오류가 여기에도 있었다. 실험대에서 여는
    문서라 성격이 같아서 같이 맞춘다.
    - 전 채널 TIMEOUT 의 원인을 극성 반대에서 미접속·단선으로 정정
    - 극성 반대 증상(`0~1 tick` 고정)을 별도 행으로 분리
    Claude-Session: https://claude.ai/code/session_017pNAbBL8bAK153kuijZ7fm
2026-09-05 docs: 전기 흐름 4장을 전 구간 11단계까지 풀어서 설명
    "한 바퀴 돌아야 흐른다"는 원리를 절 맨 앞에 두고, 기존 5단계 표에는
    비유 열을 붙였다. USB 5V 부터 GND 를 거쳐 USB 의 - 쪽으로 돌아오기까지
    실제로 전기가 지나는 곳 11 단계를 새 표로 추가했다. 배선을 확인할 때
    순서대로 짚어 볼 수 있게 하기 위함이다.
    초보자가 실제로 틀리는 두 가지(GND 줄 누락, LED 역방향)를 절 끝에 모으고,
    검출 LED 는 저항이 없어 역방향 시 과전류가 흐른다는 경고와
    실수_방지_체크리스트 링크를 덧붙였다.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
2026-09-05 docs: 발광 LED 를 3개 쓰는 이유를 6장에 추가하고 예시 오류 수정
    색이 하나면 왜 부족한지를 말로만 적어 두었던 것을, 맑은 물과 빨간 색소물이
    빨간 빛에서 같은 값이 나오는 비교표로 바꿔 눈에 보이게 했다.
    왜 하필 빨강·초록·파랑인지, 왜 4개·5개가 아닌지를 새 절로 나눠 적었다.
    기존 서술은 "빨간 색소물과 우유물이 비슷한 값"이라고 했는데 바로 아래
    광학 지문 표에는 두 액체의 빨강 값이 정반대(짧음/김)로 적혀 있었다.
    표를 기준으로 실제 겹치는 짝인 맑은 물-빨간 색소물로 고쳤다.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
2026-09-05 docs: 로그 읽는 법을 8장으로 추가
    Phase 1·2 는 OLED 가 없어 UART 로 찍히는 CSV 만 보고 판단해야 하는데,
    그 숫자를 읽는 법이 어느 문서에도 없었다. seq·ch·status·ticks·us·ovf 를
    칸별로 풀어 쓰고, 한 줄을 통째로 읽는 예시를 넣었다.
    ticks 는 밝기가 아니라 "새는 데 걸린 시간"이라 값이 클수록 어둡다는 점을
    경고 박스로 못박았다. 초보자가 방향을 반대로 읽기 쉬운 지점이다.
    이상 신호 판별표는 실수_방지_체크리스트와 같은 항목을 쓰되,
    "0~1 tick 고정"과 "전 채널 TIMEOUT"을 붙여 두고 증상이 정반대이므로
    원인도 정반대임을 명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
2026-09-05 docs: 검출 LED 첫 삽입 시 임시 저항 안전 절차를 체크리스트에 추가
    극성은 값으로만 확정되는데 값을 보려면 일단 꽂아야 하고, 잘못 꽂은 채로
    꽂는 순간이 곧 과전류가 흐르는 순간이다. 이 앞뒤가 막힌 상황을 D7 과
    검출 LED 사이에 220Ω 을 임시로 끼워 푸는 절차를 2절에 넣었다.
    확인이 끝나면 저항을 빼고 직결로 되돌린 뒤 본 측정을 한다.
    본 측정에서 빼는 이유도 함께 적었다. 측정 원리 자체는 저항이 있어도
    성립하지만(방전 중 핀이 하이 임피던스라 저항 양단 전압차가 거의 0),
    브레드보드 접점이 늘고 고임피던스 노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
2026-09-06 docs: 판별 로직 설명 문서 추가
    classify.c 의 판별 흐름을 말로 설명할 수 있게 정리했다.
    시간→밝기→비율→이름 4단계, 숫자 예시, 예상 질문과 답을 담았다.
    Claude-Session: https://claude.ai/code/session_01LtGockd1B5BuVuPhQkhc9P
2026-09-06 chore: 대회 안내 PDF 를 공모전자료/ 로 옮기고 이름을 짧게 정리
    주최측 배포 자료라 프로젝트 산출물과 성격이 다르다.
    최상위를 비우고 참고 자료끼리 한곳에 모았다. 참조하던 곳은 없었다.
    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
2026-09-06 docs: README 구성 트리와 문서 표를 실제 저장소 상태에 맞춤
    구성 트리에 docs 본체·제출물·공모전자료·backup 이 빠져 있었다.
    문서 표에도 측정 프로토콜, 실수 방지 체크리스트, 차광챔버 제작,
    판별 로직 설명이 없어 네 건을 추가했다.
    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
2026-09-08 fix: OLED 결과 화면에서 시료 이름이 잘리던 문제 수정
    "RESULT:" 뒤 9열에 이름을 붙이면 화면 21자 중 12자만 남아, 가장 긴 이름인
    "DISTILLED WATER"(15자)가 "DISTILLED WA" 로 잘려 표시됐다. ssd1306.c 가
    화면 밖을 조용히 버리므로 오류 없이 잘린 채로 나와 알아채기 어려웠다.
    비어 있던 8번째 줄(page 7)을 써서 이름이 한 줄을 통째로 쓰게 했다.
    시료 이름을 줄이지 않아도 되므로 설계 스펙 6.1절·브링업·동영상 시나리오의
    이름 표기를 그대로 둘 수 있다.
    avr-gcc(Studio Debug 동일 플래그)로 빌드 검증: 경고 0건,
    Flash 6,672 B / SRAM 90 B 로 수정 전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
    [main.c]
2026-09-08 docs: Phase 4 브링업 2단계를 실제 버튼 동작에 맞게 수정
    "짧게 누름 -> UART 로 측정 로그" 는 성립하지 않는다. main.c 는
    `ev == BTN_SHORT && g_trained` 일 때만 측정을 시작하는데, 갓 산 보드는
    EEPROM 이 0xFF 라 g_trained 가 0 이다. 즉 짧게 눌러도 무반응이 정상이다.
    길게 누름(학습 모드 진입) 역시 화면만 바꿀 뿐 UART 에는 아무것도 남기지
    않는다. 그대로 따라 하면 멀쩡한 버튼 배선을 의심하게 된다.
    부팅 시 나오는 CSV 헤더로 포트를 먼저 확인하고, "길게 -> 짧게" 를 해야
    첫 로그가 나온다는 순서로 고쳤다.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
2026-09-08 fix: 프로그램 흐름도의 EEPROM 중심점 크기를 실제 구현에 맞춤
    흐름도가 "시료군 수 x 3채널 x 4바이트" 라고 적고 있었으나, store.c 는
    중심점을 uint16 으로 저장한다. 실제로는 3클래스 x 3채널 x 2바이트 = 18B
    이고, 설계 스펙 8절의 EEPROM 배치표와도 어긋나 있었다.
    이 그림은 계획서 6.8절과 예선 PPT 슬라이드 7 에 그대로 들어간다.
    PNG 도 함께 다시 렌더했다.
    Claude-Session: https://claude.ai/code/session_01DZcvvswUpGBQQ9XBWTxZ7c
2026-09-08 fix: render_figures.sh 가 Windows 경로를 넘기지 못하던 문제 수정
    python -c 코드 문자열 안에 POSIX 경로("/c/Users/...")를 넣고 있었다.
    이 자리는 MSYS2 경로 변환이 걸리지 않아 Windows 파이썬이 "C:\c\Users\..."
    로 해석하고 FileNotFoundError 를 낸다. 결과적으로 이 환경에서는 스크립트가
    아예 돌지 않았다.
    make_flow_png.sh 는 같은 함정을 이미 $WINTMP 로 피하고 주석까지 달아 두었다.
    같은 방식으로 통일하고, Chrome 이 조용히 실패했을 때 알아채도록 PNG 생성
    여부 확인을 추가했다.
    검증: 고친 스크립트가 fig1·fig3 를 커밋본과 바이트 단위로 동일하게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
2026-09-08 docs: Phase 4 메모리 수치를 실측본(6,672 B)으로 통일
    같은 수치가 두 갈래로 적혀 있었다.
    6,672 B (20.4%) — README.md, firmware/README.md
    6,634 B (20.2%) — make_ppt.py, 동영상 시나리오, 브링업 체크리스트
    퍼센트는 각자 자기 값과 맞아 서로 다른 빌드의 값이었다. 옛 값이 예선
    제출물(PPT)과 동영상 자막에 박혀 있어 실측본으로 맞췄다.
    avr-gcc 로 Studio Debug 와 같은 플래그로 4개 프로젝트를 빌드해 확인:
    176/0, 1,430/89, 1,360/121, 6,672/90 으로 README 표와 정확히 일치한다.
    PPT 초안(22장)도 다시 생성했다. 고친 흐름도가 함께 반영된다.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
2026-09-08 docs: 존재하지 않는 배선도 파일 참조 제거
    참고 절이 `docs/배선도_Phase1.pdf` (11칸) 를 가리키고 있었으나 그런
    파일은 없다. docs/ 에는 배선도.pdf 와 제작도면.pdf 뿐이다.
    "11칸" 이 가리키던 것은 기존 배선도 4장 확인표 26칸 중 Phase 1 에서
    꽂는 부분이다. 실제로 GND 2 + 적 5 + 검출 4 = 11칸으로 정확히 맞으므로,
    따로 도면을 만드는 대신 어느 칸이 해당되는지를 적었다.
    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
2026-09-08 docs: 장바구니 합계를 항목 합과 일치시킴
    표기는 48,400원인데 항목 소계를 더하면 43,400원이었다. 큐벳·주사기는
    소계가 "-" 로 비어 있어 어디서 5,000원이 붙었는지 알 수 없었다.
    - 뒤쪽 "LED" 절에서 이미 "일단 빼고 진행" 으로 결론난 IR LED 를 표에서도
    보류로 표시하고, 위쪽 "같이 살 것" 문장도 같은 결론으로 맞췄다
    - 총액을 43,000원(= 금액이 적힌 항목의 정확한 합)으로 고치고, 큐벳·주사기·
    시료를 뺀 이유를 명시했다
    - 계획서 예상액과의 차액 근거를 다시 계산했다. 이전 서술("나머지 품목은
    오히려 조금 줄었다")은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
2026-09-08 docs: 큐벳 내부 단면·용량이 미확정임을 표에도 드러냄 (B-1)
    차광챔버_제작.md 4절 표가 "내부 단면 10 x 10mm", "용량 1.6mL(최소 권장)
    ~ 4.5mL(가득)" 이라고 단정해 놓고, 40여 줄 아래 경고에서 "세미마이크로
    구조(10 x 4mm)일 가능성이 높고 1.6mL 는 최대 용량" 이라고 그 표를
    부정하고 있었다. 구매목록.md 큐벳 절도 같은 상태였다.
    표만 읽고 넘어가면 주입량을 4.5mL 기준으로 잡아 큐벳을 넘치게 한다.
    확실한 값(광로 10mm, 외형)과 실측이 필요한 값(내부 단면, 용량)을
    표에서 구분하고, 챔버 치수는 전자만 쓰므로 영향받지 않음을 명시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
2026-09-08 docs: 쉬운_설명의 LED 흡수 파장 설명과 발광 시간 서술 수정 (B-4, B-5)
    **LED 흡수 파장 (B-4).** "자기가 내는 빛보다 에너지가 센 빛만 느낍니다"
    라고 써 놓고 바로 다음 줄에서 "빨간 LED는 빨강·초록·파랑을 전부 느낍니다"
    라고 했다. 빨강은 "더 센 빛" 이 아니므로 그 자체로 모순이다.
    구매목록.md 는 같은 내용을 "자기 발광 파장 **이하**" 로 정확히 적고 있어
    문서끼리도 어긋나 있었다. "같거나 더 짧은 파장" 으로 통일했다.
    덧붙여, 빨강은 경계에 걸려 가장 약하게 감지된다는 사실을 적었다.
    Red 채널 값이 크게 나오는 것을 고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
2026-09-08 docs: PPT 골격을 실제 생성 스크립트·진행 상황에 맞춤 (B-6)
    골격 문서가 make_ppt.py 보다 오래돼 두 곳이 어긋나 있었다.
    - 슬라이드 9: "검출 LED를 투명(무착색)으로 고른 이유" — 계획서_수정사항
    ③항이 "투명만으로는 부족하고 반드시 적색" 으로 고치라고 한 바로 그
    문구다. make_ppt.py 는 이미 "투명 렌즈 + 적색" 으로 반영돼 있었다.
    - 슬라이드 10: "예선 시점에 Phase 1~2까지 완료했음을 명시" — 완료된 것은
    펌웨어 구현·빌드 검증이고 하드웨어 측정은 아직이다. 그대로 쓰면 실측
    데이터를 요구받았을 때 답할 것이 없다. m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
2026-09-08 fix: EEPROM 임계값 절단 방지, 버튼 사문 조건 정리 (C-1, C-2)
    **store.c (C-1).** threshold_d2 는 uint32 인데 EEPROM 배치상 2바이트다.
    `(uint16_t)` 캐스트로 그냥 잘라 쓰고 있어서, d2 이론 최대치(3,000,000)
    근처 값을 넣으면 조용히 뒤집힌다. 예를 들어 70000 은 4464 가 되어
    "전부 UNKNOWN" 이 되는데 원인이 저장 단계라 추적이 어렵다.
    넘치면 0xFFFF 로 붙인다. 거리로 약 256 이라 사실상 "무엇이든 받아들임"
    이므로 임계값을 키우려던 의도와 어긋나지 않는다.
    **button.c (C-2).** `if (!was_long && held >= 1)` 의 뒷조건은 바깥
    `if (g_held > 0)` 때문에 항상 참이라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
    [button.c, store.c]
2026-09-08 docs: measure_avg 의 부분 타임아웃 편향을 주석으로 남김 (C-3)
    한 채널을 3회(학습 8회) 재는 동안 일부만 TIMEOUT 이면 성공한 회차만
    평균낸다. 남은 회차는 "그나마 빨리 끝난" 것들이라 평균이 실제보다 밝은
    쪽으로 치우친다. g_timeout_ch 는 채널 전체가 실패해야 서므로 화면에도
    흔적이 남지 않는다.
    실측 데이터가 없어 이 상황의 빈도를 모르는 상태라 동작은 바꾸지 않았다.
    측정 의미를 바꾸는 결정은 Phase 1 재현성(CV) 데이터를 보고 내려야 한다.
    대신 사실과 선택지 두 가지를 주석에 적어 두었다.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
2026-09-08 fix: analyze.py 가 1회 측정을 CV 통과로 세던 문제 수정 (C-4, C-5)
    측정이 1회뿐이면 표본표준편차가 정의되지 않아 stats() 가 sd=0 을
    돌려준다. 그대로 비교하면 CV 0% 가 되어 "통과" 로 찍혔다. 재현성을
    전혀 확인하지 않은 것을 통과로 세는 셈이라, 로그를 잘못 나눠 저장했을 때
    Phase 1 조건 1 을 통과했다고 오판할 수 있었다.
    n < 2 는 "판정 불가 (2회 이상 필요)" 로 따로 표시하고 종합 판정에서도
    통과로 세지 않는다. 합성 로그로 두 경로 모두 확인했다.
    덧붙여 종합 판정 절의 주석 번호가 "4." 로 중복돼 있던 것을 "5." 로
    고쳤다 (출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
    [analyze.py]
2026-09-08 docs: 검출 LED 캐소드를 다리 길이로 지시하던 곳 정리 (C-7)
    실수_방지_체크리스트 2절이 "브링업에서 다리 길이만 보고 두 번 반대로
    꽂았다, 다리 길이로 판별하지 말 것" 이라고 못 박아 두었는데, 정작
    작업대에서 여는 firmware/README.md 3-1절과 브링업 체크리스트 4단계는
    여전히 "캐소드(짧은 다리)" 로 지시하고 있었다.
    두 곳 모두 "렌즈 안의 큰 컵" 판별법과 "0~1 tick 이면 그대로 180° 돌려
    꽂기" 로 바꿨다. 정확한 정보가 덜 읽히는 문서에만 있던 상태를 해소한다.
    같은 커밋에서 firmware/README.md 의 명령줄 빌드 주석도 고쳤다.
    "avr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
2026-09-08 chore: C-1 반영으로 늘어난 Phase 4 Flash 수치 갱신 (6,690 B)
    store.c 의 임계값 클램프가 18바이트를 더해 6,672 -> 6,690 B 가 됐다.
    퍼센트는 20.4% 로 그대로다. 표기가 있는 5곳을 모두 맞추고 PPT 초안을
    다시 생성했다.
    avr-gcc 로 재확인: 경고 0건, 176/0 · 1,430/89 · 1,360/121 · 6,690/90.
    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
2026-09-08 docs: Phase 1~4 회로 동작과 LED 결과 정리 문서 추가
    "각 단계를 진행하면 발광·검출 LED 가 어떻게 되는가" 를 한곳에 모았다.
    기존 문서는 원리(쉬운_설명), 계산(판별_로직_설명), 진단(실수_방지)으로
    나뉘어 있어 회로 관점의 흐름을 한 번에 볼 곳이 없었다.
    실측이 아직 없으므로 세 종류를 기호로 구분했다.
    확정(코드·회로가 정함) / 실측(2026-09-05 브링업) / 예상(계산)
    PPT 에는 앞의 둘만 쓰고 예상값은 측정 후 교체하도록 명시했다.
    정리 중 확인된 것: 측정 1회는 5.1ms 고정 + 방전시간인데 TIMEOUT 이면
    2.0초다. 차광이 잘 될수록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
2026-09-08 docs: 문서 PDF 생성 스크립트 추가하고 회로 동작 문서를 PDF 로 남김
    마크다운 문서를 A4 PDF 로 뽑는 도구가 없었다. 기존 PDF 스크립트
    (make_wiring_pdf.sh 등)는 전부 SVG -> PDF 라 문서에는 쓸 수 없었다.
    tools/make_doc_pdf.sh + tools/md_to_html.py 를 추가했다. 저장소의 기존
    방식을 그대로 따른다 — Chrome 헤드리스 print-to-pdf, 한글 경로가 file://
    URL 에서 깨지므로 ASCII 임시 경로 경유, Windows 프로그램에 넘기는 경로는
    $WINTMP 사용, 페이지 수 확인.
    인쇄용으로 조정한 점 두 가지:
    - nl2br 을 쓰지 않는다. 원본이 72자에서 손으로 줄바꿈되어 있어 <br>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
2026-09-08 feat: 단계별 배선도(Phase 1/2/4)를 백업 브랜치에서 가져옴
    backup/2026-09-05-초기화전 에만 있던 단계별 배선도를 master 로 옮긴다.
    그 브랜치의 나머지(제작문서 PDF 14종, PPT 시안, 논문 스캔, sheet7 작업)는
    가져오지 않았다.
    **통째로 체리픽하지 않은 이유.** 그 브랜치의 build_drawings_lib.py 에는
    두 가지가 섞여 있다 — 단계별 도면이 쓰는 text_width() 와, 챔버 도면을
    6장에서 7장으로 늘리던 미완성 작업(Sheet 기본값 total=7)이다. 후자까지
    가져오면 6장짜리 도면에 "1 / 7" 푸터가 찍힌다. text_width() 만 옮겼다.
    챔버 도면이 여전히 6장이고 푸터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
